akos712/projectY/ProjectY.png

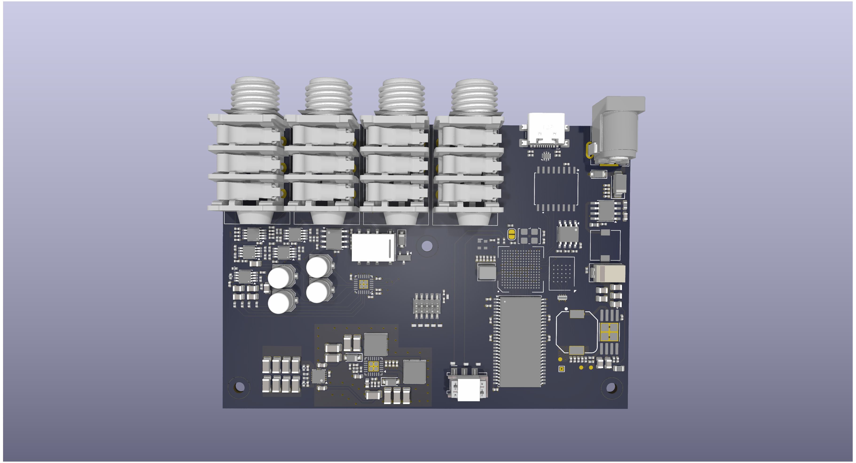
ProjectY.png
