akos712/projectY/ProjectY_3D_december.step

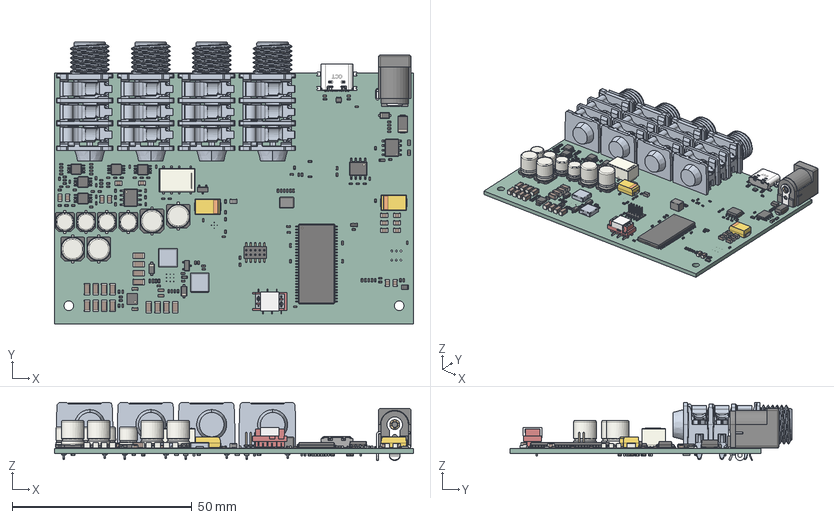
[picture p2: CAD file, 2025-12-16]
ProjectY_3D_december.step
100.0 x 78.6 x 16.2 mm
C_0402 x 100
Q_SOT-23
R_0402 x 58
C_Elec_6.3x7.7 x 4
ProjectY_3D_december 1.5.1 x 2
C_1206 x 16
C_Elec_5x5.8 x 4
SOT-666
C_0805 x 14
TI_SO-PowerPAD-8
R_0402_1005Metric x 4
J_Wurth_WR-MM_690367280676
R_0603 x 3
L_0805_2012Metric
Relay_DPDT_Omron_G6K-2F-Y
L_Wuerth_MAPI-4030
CP_EIA-7343-31_Kemet-D x 2
Texas_S-PVSON-N10
VSSOP-8_3x3mm_P0.65mm x 5
SOT-23
D_SOD-123FL
C_0603_1608Metric x 2
SOIC-8_3.9x4.9mm_P1.27mm x 2
R_0805
C_0603 x 3
PinHeader_2x05_P1.27mm_Vertical_SMD
D_SMA
D_SOD-123 x 2
R_0402x4
USB4110-GF-A_revB(1) MF
TSOP-II-54_22.2x10.16mm_P0.8mm
DFN1006-2L-RD x 6
R_0805_2012Metric x 4
ProjectY_PCB
