akos712/projectY/ProjectY_3D_latest.step

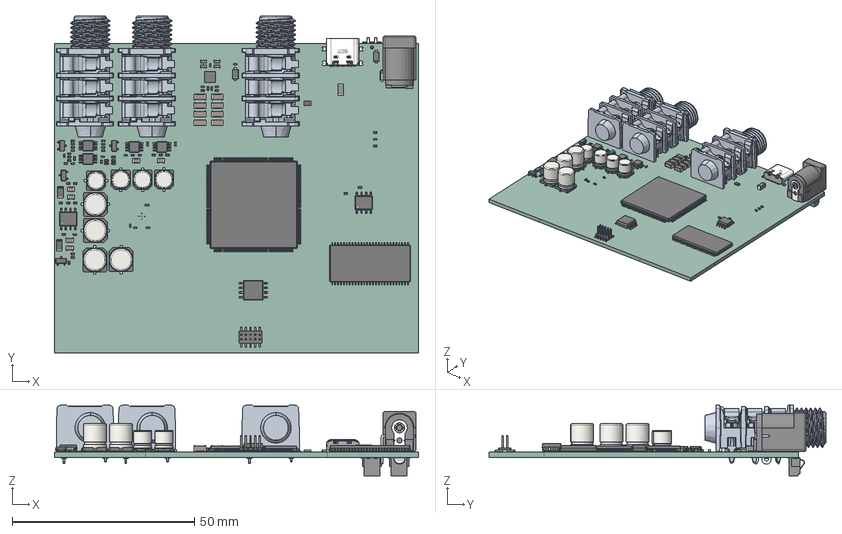
[picture p3: CAD file, 2025-10-03]
ProjectY_3D_latest.step
100.0 x 92.5 x 19.4 mm
C_Elec_6.3x7.7 x 4
C_0402 x 24
C_0603 x 4
C_Elec_5x5.8 x 4
C_1206 x 8
R_0402 x 27
SOT-23 x 4
R_0402_1005Metric x 6
R_1206 x 2
C_0805 x 6
L_1206_3216Metric
Texas_S-PVSON-N10
VSSOP-8_3x3mm_P0.65mm x 4
D_SOD-123FL x 2
SOIC-8_5.3x5.3mm_P1.27mm
SOIC-8_3.9x4.9mm_P1.27mm x 2
PinHeader_2x05_P1.27mm_Vertical_SMD
USB4110-GF-A_revB(1) MF
LQFP-176_24x24mm_P0.5mm
R_0805
TSOP-II-54_22.2x10.16mm_P0.8mm
00-9155-002-852-00X-STP-BM x 2
ProjectY_PCB
