akos712/projectY/ProjectY.step

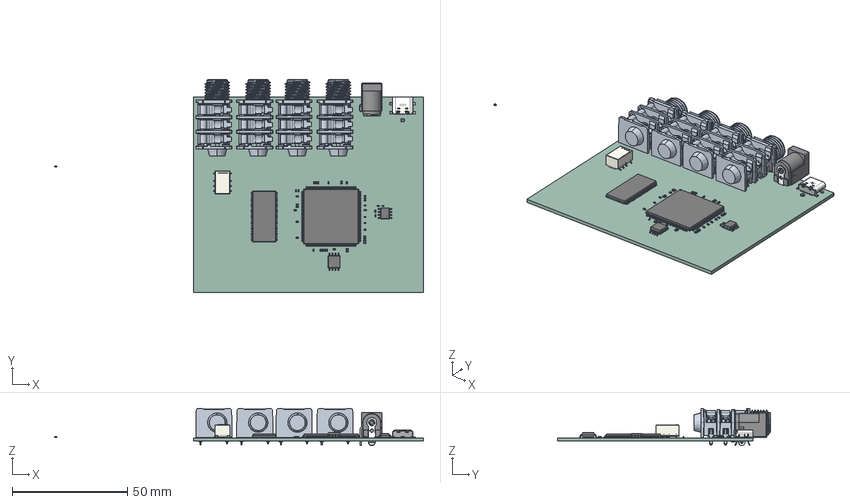
[picture p4: CAD file, 2025-08-23]
ProjectY.step
160.4 x 92.6 x 16.2 mm
SOT-666
C_0402 x 36
LQFP-176_24x24mm_P0.5mm
R_0402 x 4
Relay_DPDT_Omron_G6K-2F-Y
SOIC-8_5.3x5.3mm_P1.27mm
USB4110-GF-A_revB(1) MF
SOIC-8_3.9x4.9mm_P1.27mm
TSOP-II-54_22.2x10.16mm_P0.8mm
ProjectY_PCB
