akos712/projectY/simulations/3V3BuckInputFilter.asc

C1: cap; 27µ
C2: cap; 220n
C3: cap; 100µ
L1: ind; 22µ; Ipk=2 Rser=100m
R2: res; 1
R3: res; 1m
V1: voltage; ""; AC 1
Named nets: 0
@19V
.ac oct 100 20 1G
