akos712/projectY/ProjectY.kicad_pcb

## KiCad design ProjectY.kicad_pcb (2026-02-17)

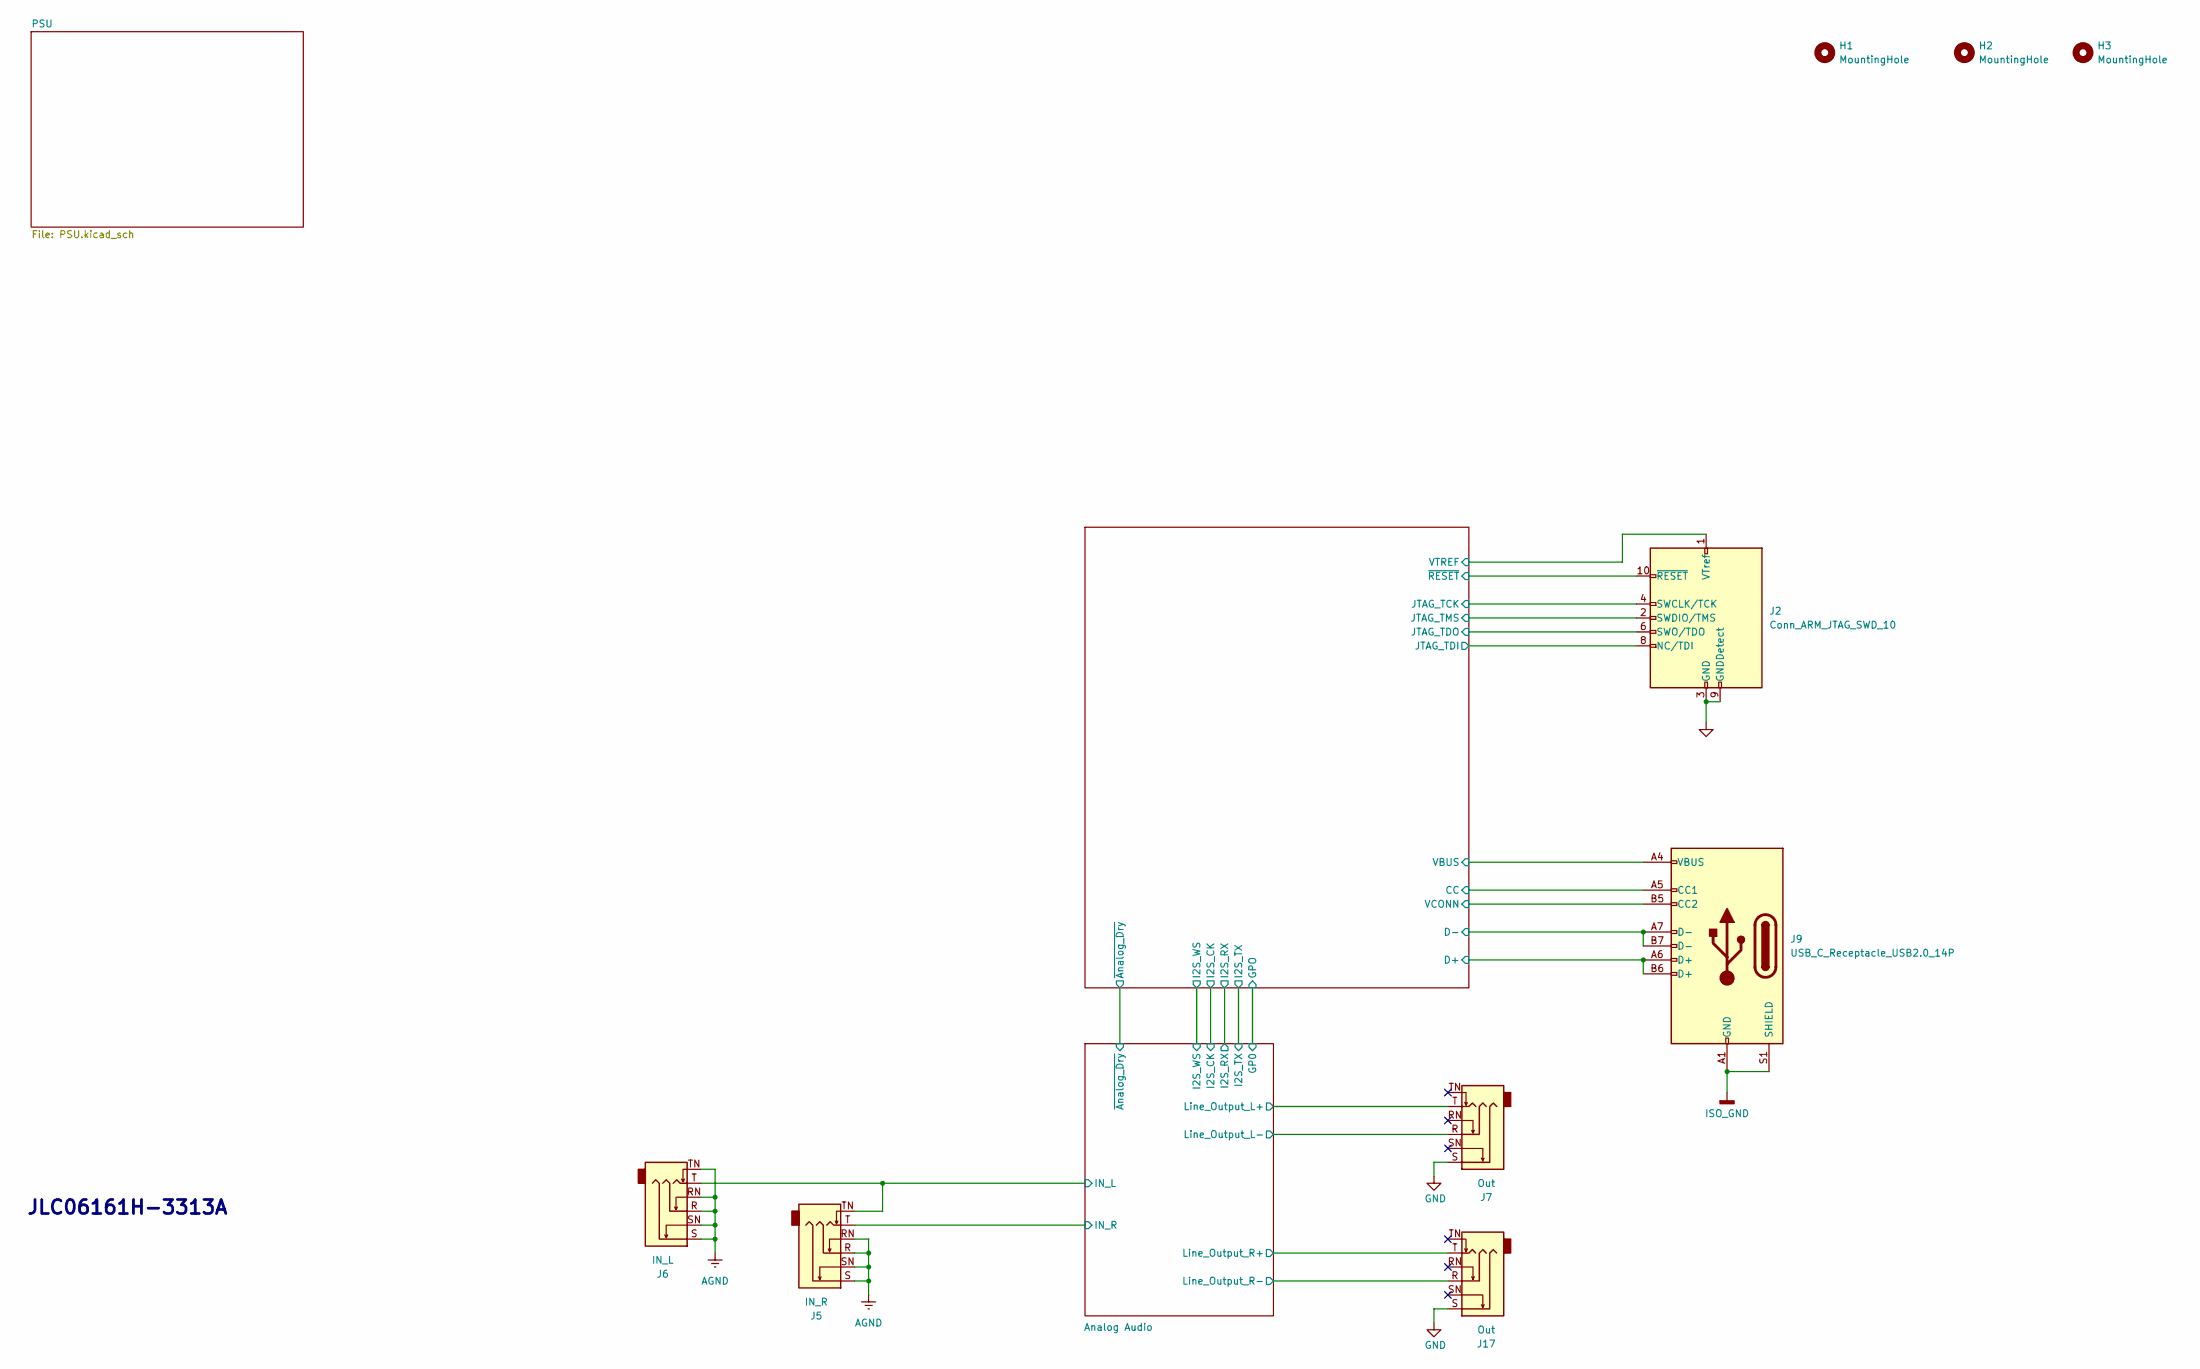
[picture p5: schematic ProjectY.kicad_sch, Project Y]

Parts:
H1, H2, H3: MountingHole; MountingHole_2.7mm_M2.5
J2: Conn_ARM_JTAG_SWD_10; PinHeader_2x05_P1.27mm_Vertical_SMD
J5: IN_R; Jack_6.35mm_Neutrik_NRJ6HF_Horizontal
J6: IN_L; Jack_6.35mm_Neutrik_NRJ6HF_Horizontal
J7, J17: Out; Jack_6.35mm_Neutrik_NRJ6HF_Horizontal
J9: USB_C_Receptacle_USB2.0_14P; USB_C_Receptacle_GCT_USB4110

Connections:
+3.3V: J2.1 (VTref); also elsewhere on the board
/Analog Audio/IN_L: J5.TN, J6.T; also elsewhere on the board
/Analog Audio/IN_R: J5.T; also elsewhere on the board
/Analog Audio/Line_Output_L+: J7.T; also elsewhere on the board
/Analog Audio/Line_Output_L-: J7.R; also elsewhere on the board
/Analog Audio/Line_Output_R+: J17.T; also elsewhere on the board
/Analog Audio/Line_Output_R-: J17.R; also elsewhere on the board
/DSP/CC: J9.A5 (CC1); also elsewhere on the board
/DSP/D+: J9.A6 (D+), J9.B6 (D+); also elsewhere on the board
/DSP/D-: J9.A7 (D-), J9.B7 (D-); also elsewhere on the board
/DSP/JTAG_TCK: J2.4 (SWCLK/TCK); also elsewhere on the board
/DSP/JTAG_TDI: J2.8 (NC/TDI); also elsewhere on the board
/DSP/JTAG_TDO: J2.6 (SWO/TDO); also elsewhere on the board
/DSP/JTAG_TMS: J2.2 (SWDIO/TMS); also elsewhere on the board
/DSP/VBUS: J9.A4 (VBUS), J9.A9 (VBUS), J9.B4 (VBUS), J9.B9 (VBUS); also elsewhere on the board
/DSP/VCONN: J9.B5 (CC2); also elsewhere on the board
/DSP/~RESET: J2.10 (~RESET); also elsewhere on the board
AGND: J5.R, J5.RN, J5.S, J5.SN, J6.R, J6.RN, J6.S, J6.SN, J6.TN; also elsewhere on the board
GND: J2.3 (GND), J2.5 (GND), J2.9 (GNDDetect), J7.S, J17.S; also elsewhere on the board
ISO_GND: J9.A1 (GND), J9.A12 (GND), J9.B1 (GND), J9.B12 (GND), J9.S1 (SHIELD); also elsewhere on the board

Notes on the sheet:
JLC06161H-3313A

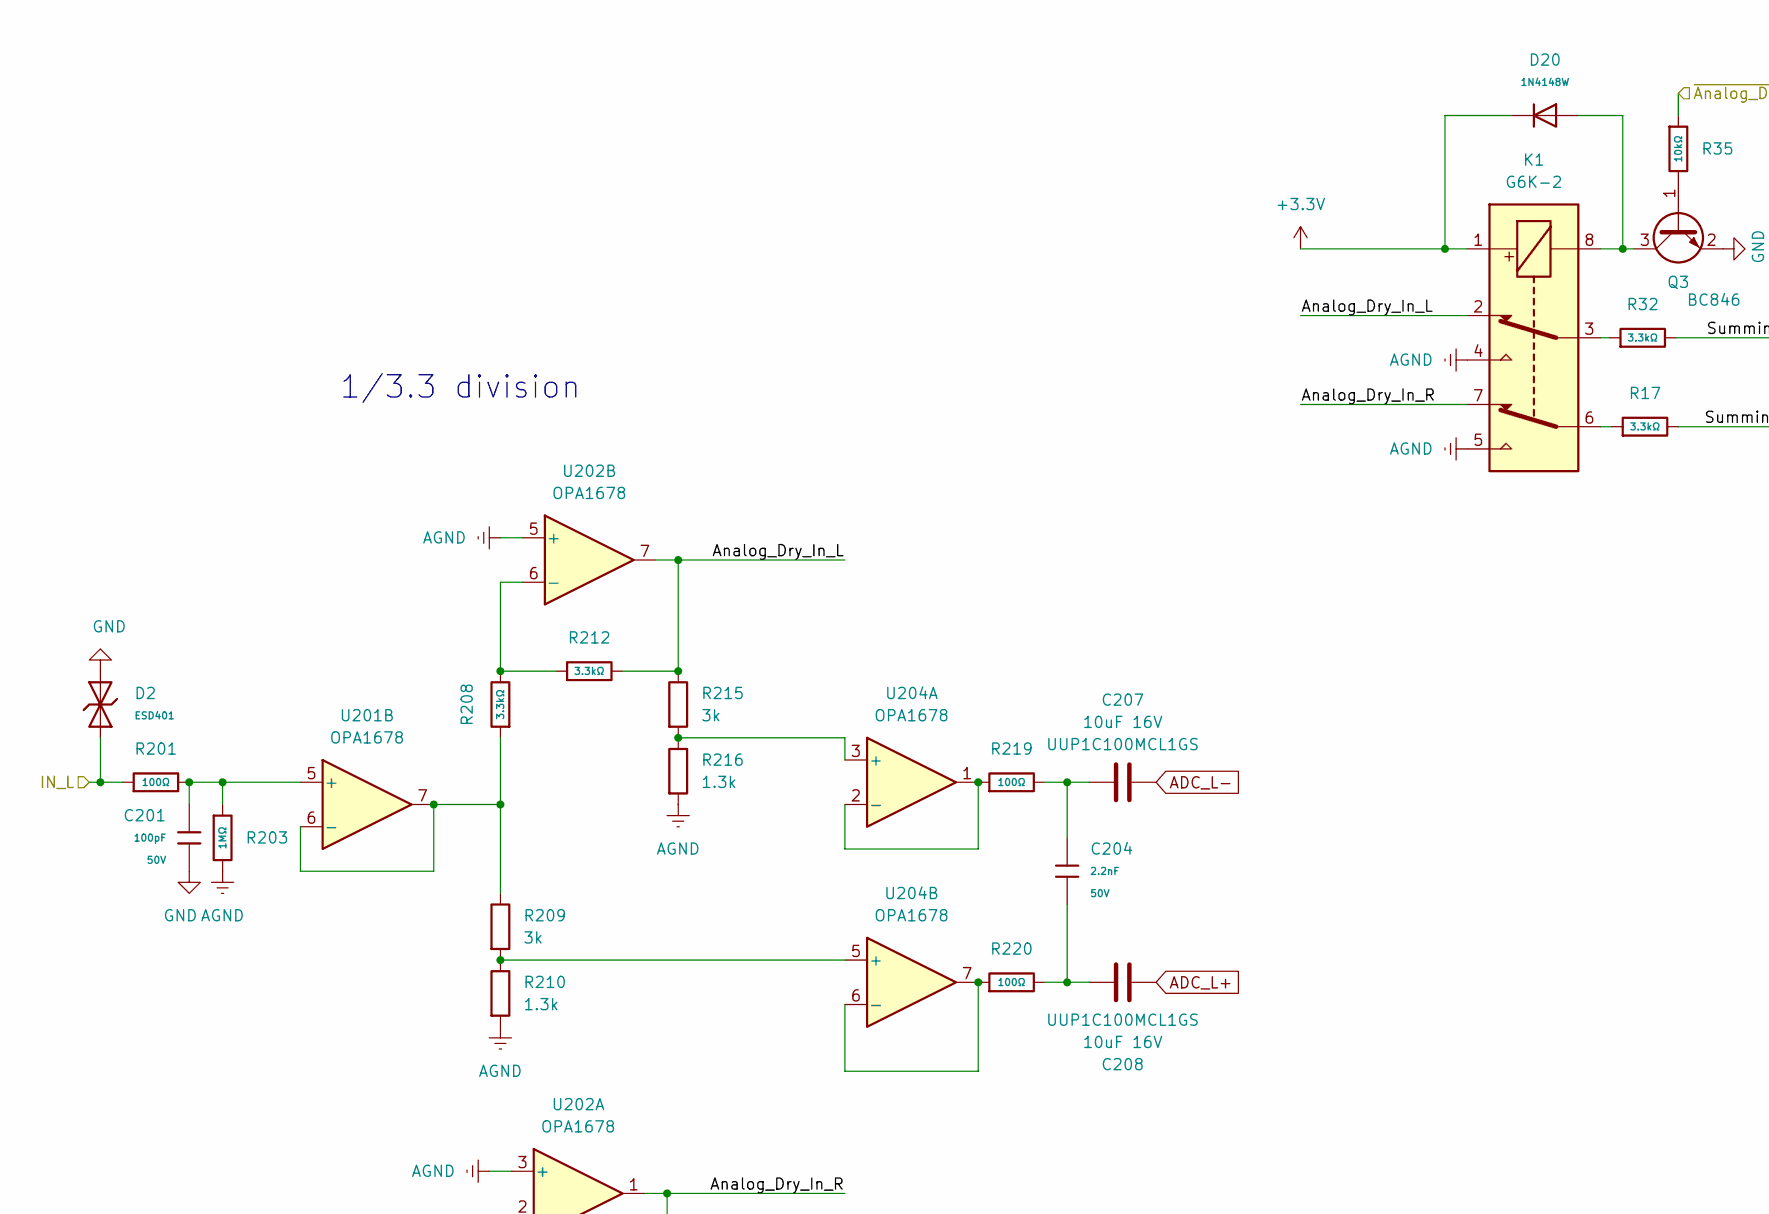
[picture p6: schematic audio.kicad_sch, Project Y, part in row 1, column 1]

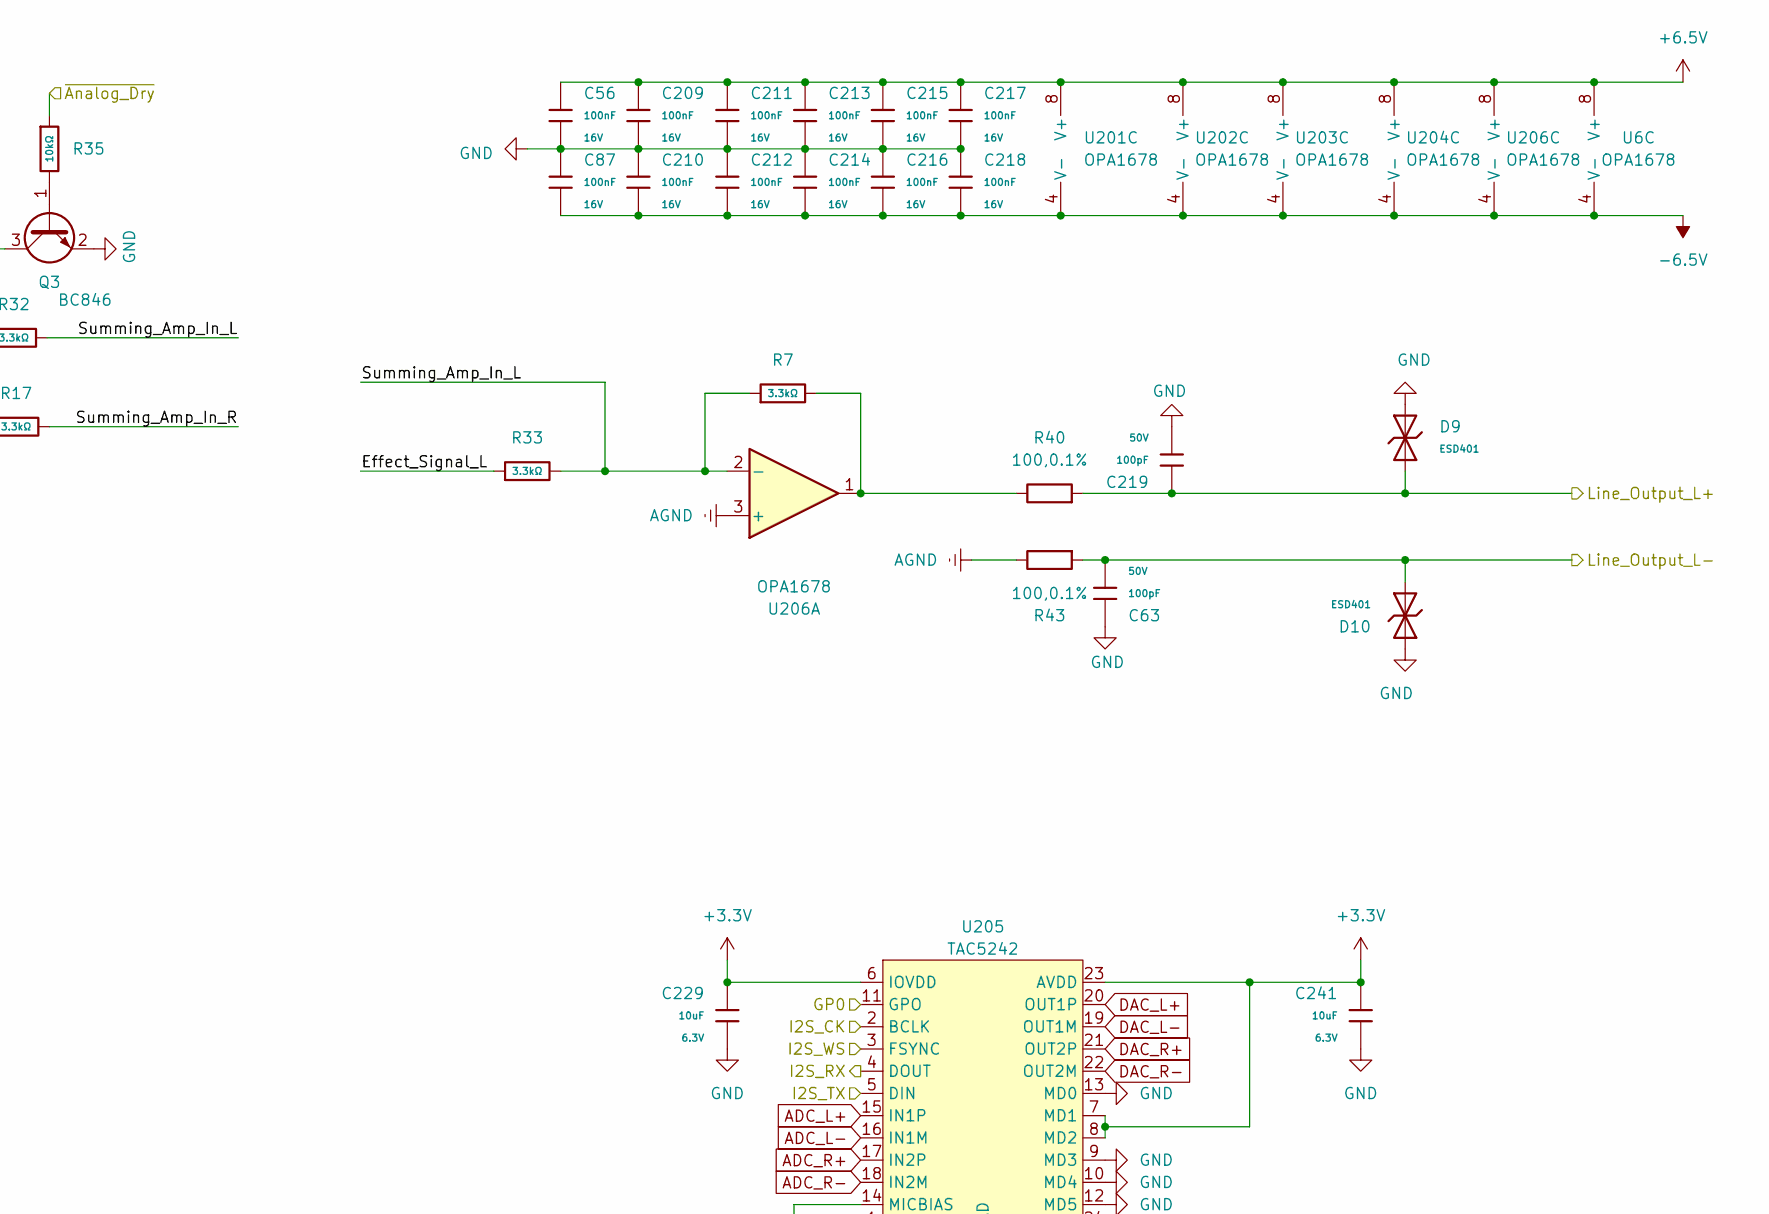
[picture p7: schematic audio.kicad_sch, Project Y, part in row 1, column 2]

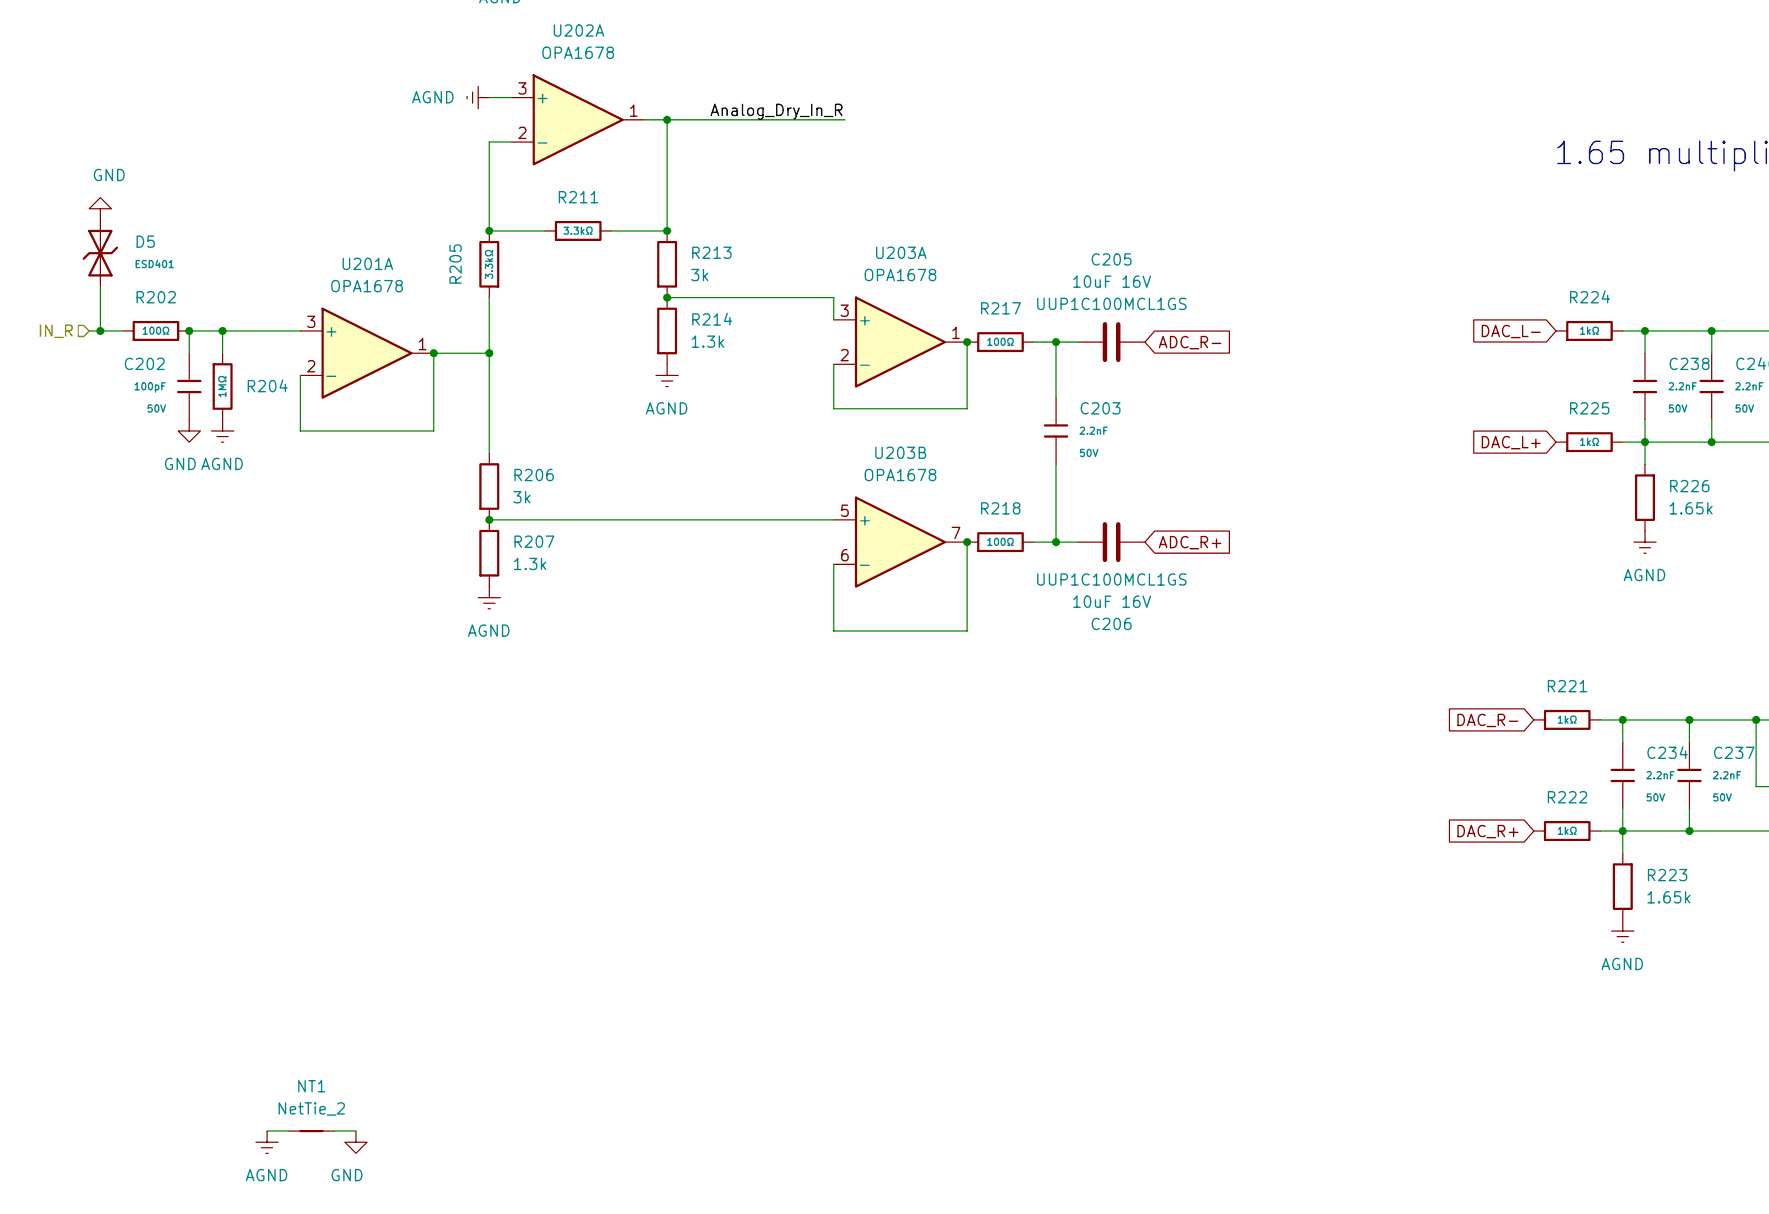
[picture p8: schematic audio.kicad_sch, Project Y, part in row 2, column 1]

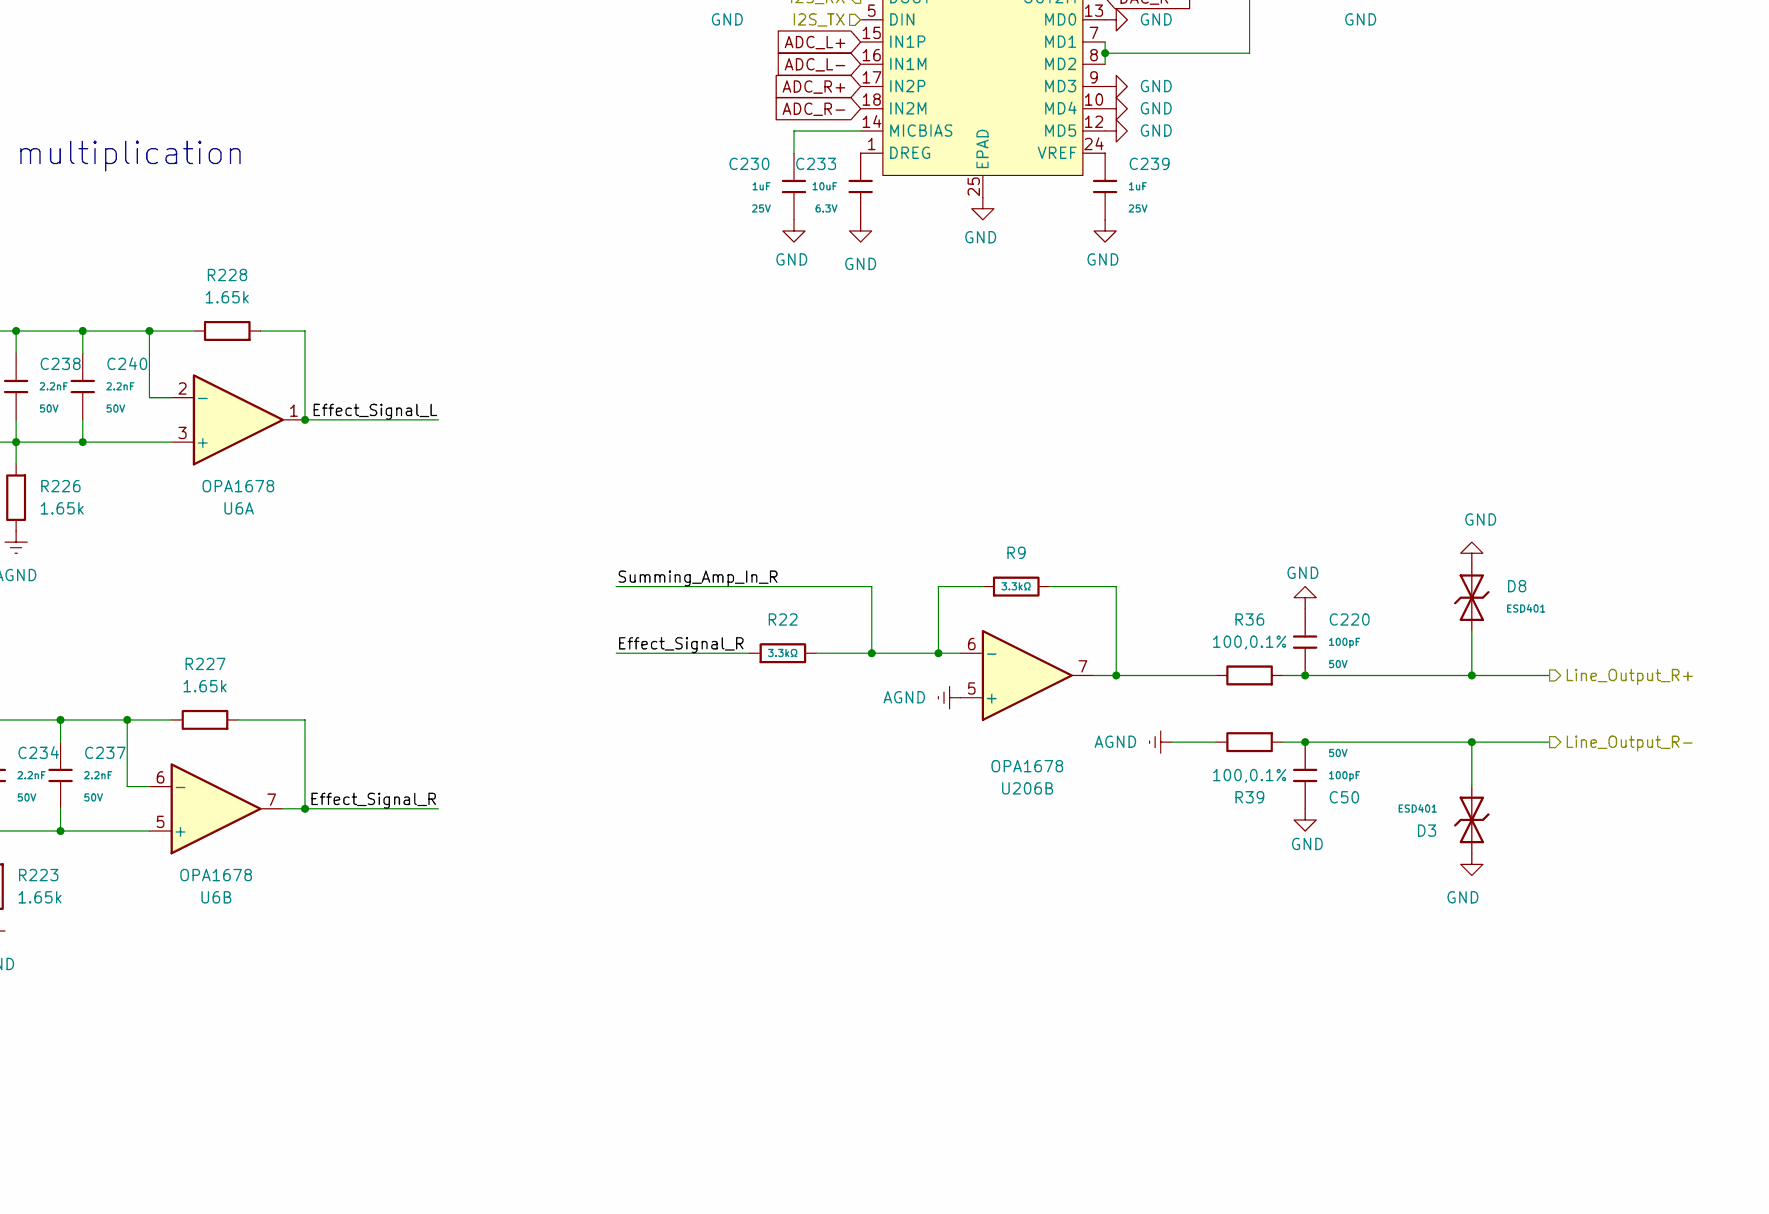
[picture p9: schematic audio.kicad_sch, Project Y, part in row 2, column 2]

Parts:
C50, C63, C201, C202, C219, C220: 100pF; C_0402; Voltage Rated 50V; Tolerance ±5%; Part 0402CG101J500NT; LCSC C1546
C56, C87, C209, C210, C211, C212, C213, C214, C215, C216, C217, C218: 100nF; C_0402; Voltage Rated 16V; Tolerance ±10%; Part CL05B104KO5NNNC; LCSC C1525
C203, C204, C234, C237, C238, C240: 2.2nF; C_0805; Voltage Rated 50V; Tolerance ±5%; Part CL21C222JBFNNNE; LCSC C28260
C205, C206, C207, C208: 10uF 16V; C_Elec_5x5.8; LCSC C1984751
C229, C233, C241: 10uF; C_0402; Voltage Rated 6.3V; Tolerance ±20%; Part CL05A106MQ5NUNC; LCSC C15525
C230, C239: 1uF; C_0402; Voltage Rated 25V; Tolerance ±10%; Part CL05A105KA5NQNC; LCSC C52923
D2, D3, D5, D8, D9, D10: ESD401; D_DFN1006-2L; Clamping Voltage@Ipp 10V; Breakdown Voltage (VBR) 5.6V; Part H5VL10B; LCSC C7420372
D20: 1N4148W; D_SOD-123; Forward Voltage (Vf@If) 1V@50mA; Reverse Voltage (Vr) 75V; Part 1N4148W; LCSC C81598
K1: G6K-2; Relay_DPDT_Omron_G6K-2F-Y
NT1: NetTie_2; NetTie-2_SMD_Pad0.5mm
Q3: BC846; SOT-23
R7, R9, R17, R22, R32, R33, R205, R208, R211, R212: 3.3kΩ; R_0402; Overload Voltage (Max) 50V; Tolerance ±1%; Part 0402WGF3301TCE; LCSC C25890
R35: 10kΩ; R_0402; Overload Voltage (Max) 50V; Tolerance ±1%; Part 0402WGF1002TCE; LCSC C25744
R36, R39, R40, R43: 100,0.1%; R_0805_2012Metric
R201, R202, R217, R218, R219, R220: 100Ω; R_0402; Overload Voltage (Max) 50V; Tolerance ±1%; Part 0402WGF1000TCE; LCSC C25076
R203, R204: 1MΩ; R_0402; Overload Voltage (Max) 50V; Tolerance ±1%; Part 0402WGF1004TCE; LCSC C26083
R206, R209, R213, R215: 3k; R_0402
R207, R210, R214, R216: 1.3k; R_0402
R221, R222, R224, R225: 1kΩ; R_0402; Overload Voltage (Max) 50V; Tolerance ±1%; Part 0402WGF1001TCE; LCSC C11702
R223, R227: 1.65k; R_0402_1005Metric
R226, R228: 1.65k; R_0402
U6, U201, U202, U203, U204: OPA1678; VSSOP-8_3x3mm_P0.65mm
U205: TAC5242
U206: OPA1678; SOIC-8_3.9x4.9mm_P1.27mm

Connections:
+3.3V: C229.1, C241.1, D20.1, K1.1, U205.6 (IOVDD), U205.7 (MD1), U205.8 (MD2), U205.23 (AVDD); also elsewhere on the board
+6.5V: C56.1, C209.1, C211.1, C213.1, C215.1, C217.1, U6.8 (V+), U201.8 (V+), U202.8 (V+), U203.8 (V+), U204.8 (V+), U206.8 (V+); also elsewhere on the board
-6.5V: C87.2, C210.2, C212.2, C214.2, C216.2, C218.2, U6.4 (V-), U201.4 (V-), U202.4 (V-), U203.4 (V-), U204.4 (V-), U206.4 (V-); also elsewhere on the board
/Analog Audio/Analog_Dry_In_L: K1.2, R212.2, R215.1, U202.7
/Analog Audio/Analog_Dry_In_R: K1.7, R211.2, R213.1, U202.1
/Analog Audio/Effect_Signal_L: R33.1, R228.2, U6.1
/Analog Audio/Effect_Signal_R: R22.1, R227.2, U6.7
/Analog Audio/GP0: U205.11 (GPO); also elsewhere on the board
/Analog Audio/I2S_CK: U205.2 (BCLK); also elsewhere on the board
/Analog Audio/I2S_RX: U205.4 (DOUT); also elsewhere on the board
/Analog Audio/I2S_TX: U205.5 (DIN); also elsewhere on the board
/Analog Audio/I2S_WS: U205.3 (FSYNC); also elsewhere on the board
/Analog Audio/IN_L: D2.1, R201.1; also elsewhere on the board
/Analog Audio/IN_R: D5.1, R202.1; also elsewhere on the board
/Analog Audio/Line_Output_L+: C219.1, D9.1, R40.2; also elsewhere on the board
/Analog Audio/Line_Output_L-: C63.2, D10.1, R43.2; also elsewhere on the board
/Analog Audio/Line_Output_R+: C220.2, D8.1, R36.2; also elsewhere on the board
/Analog Audio/Line_Output_R-: C50.2, D3.1, R39.2; also elsewhere on the board
/Analog Audio/Summing_Amp_In_L: R7.1, R32.2, R33.2, U206.2 (-)
/Analog Audio/Summing_Amp_In_R: R9.1, R17.2, R22.2, U206.6 (-)
/Analog Audio/~Analog_Dry: R35.1; also elsewhere on the board
ADC_L+: C208.1, U205.15 (IN1P)
ADC_L-: C207.1, U205.16 (IN1M)
ADC_R+: C206.1, U205.17 (IN2P)
ADC_R-: C205.1, U205.18 (IN2M)
AGND: K1.4, K1.5, NT1.1, R39.1, R43.1, R203.2, R204.2, R207.2, R210.2, R214.2, R216.2, R223.1, R226.1, U202.3 (+), U202.5 (+), U206.3 (+), U206.5 (+); also elsewhere on the board
DAC_L+: R225.1, U205.20 (OUT1P)
DAC_L-: R224.1, U205.19 (OUT1M)
DAC_R+: R222.1, U205.21 (OUT2P)
DAC_R-: R221.1, U205.22 (OUT2M)
GND: C50.1, C56.2, C63.1, C87.1, C201.2, C202.2, C209.2, C210.1, C211.2, C212.1, C213.2, C214.1, C215.2, C216.1, C217.2, C218.1, C219.2, C220.1, C229.2, C230.2, C233.2, C239.2, C241.2, D2.2, D3.2, D5.2, D8.2, D9.2, D10.2, NT1.2, Q3.2 (E), U205.9 (MD3), U205.10 (MD4), U205.12 (MD5), U205.13 (MD0), U205.25 (EPAD), U205.A1 (VSS), U205.A2 (VSS), U205.A3 (VSS), U205.A4 (VSS); also elsewhere on the board
unnamed: C203.1, C206.2, R218.2
unnamed: C203.2, C205.2, R217.2
unnamed: C204.1, C208.2, R220.2
unnamed: C204.2, C207.2, R219.2
unnamed: K1.3, R32.1
unnamed: K1.6, R17.1
unnamed: Q3.1 (B), R35.2
unnamed: D20.2, K1.8, Q3.3 (C)
unnamed: R9.2, R36.1, U206.7
unnamed: R7.2, R40.1, U206.1
unnamed: C238.1, C240.1, R225.2, R226.2, U6.3 (+)
unnamed: C238.2, C240.2, R224.2, R228.1, U6.2 (-)
unnamed: C234.1, C237.1, R222.2, R223.2, U6.5 (+)
unnamed: C234.2, C237.2, R221.2, R227.1, U6.6 (-)
unnamed: C202.1, R202.2, R204.1, U201.3 (+)
unnamed: R205.1, R206.1, U201.1, U201.2 (-)
unnamed: C201.1, R201.2, R203.1, U201.5 (+)
unnamed: R208.1, R209.1, U201.6 (-), U201.7
unnamed: R205.2, R211.1, U202.2 (-)
unnamed: R208.2, R212.1, U202.6 (-)
unnamed: R213.2, R214.1, U203.3 (+)
unnamed: R217.1, U203.1, U203.2 (-)
unnamed: R206.2, R207.1, U203.5 (+)
unnamed: R218.1, U203.6 (-), U203.7
unnamed: R215.2, R216.1, U204.3 (+)
unnamed: R219.1, U204.1, U204.2 (-)
unnamed: R209.2, R210.1, U204.5 (+)
unnamed: R220.1, U204.6 (-), U204.7
unnamed: C233.1, U205.1 (DREG)
unnamed: C230.1, U205.14 (MICBIAS)
unnamed: C239.1, U205.24 (VREF)

Notes on the sheet:
1.65 multiplication
1/3.3 division
