akos712/projectY/ProjectY.kicad_pcb

## KiCad design ProjectY.kicad_pcb (continued)

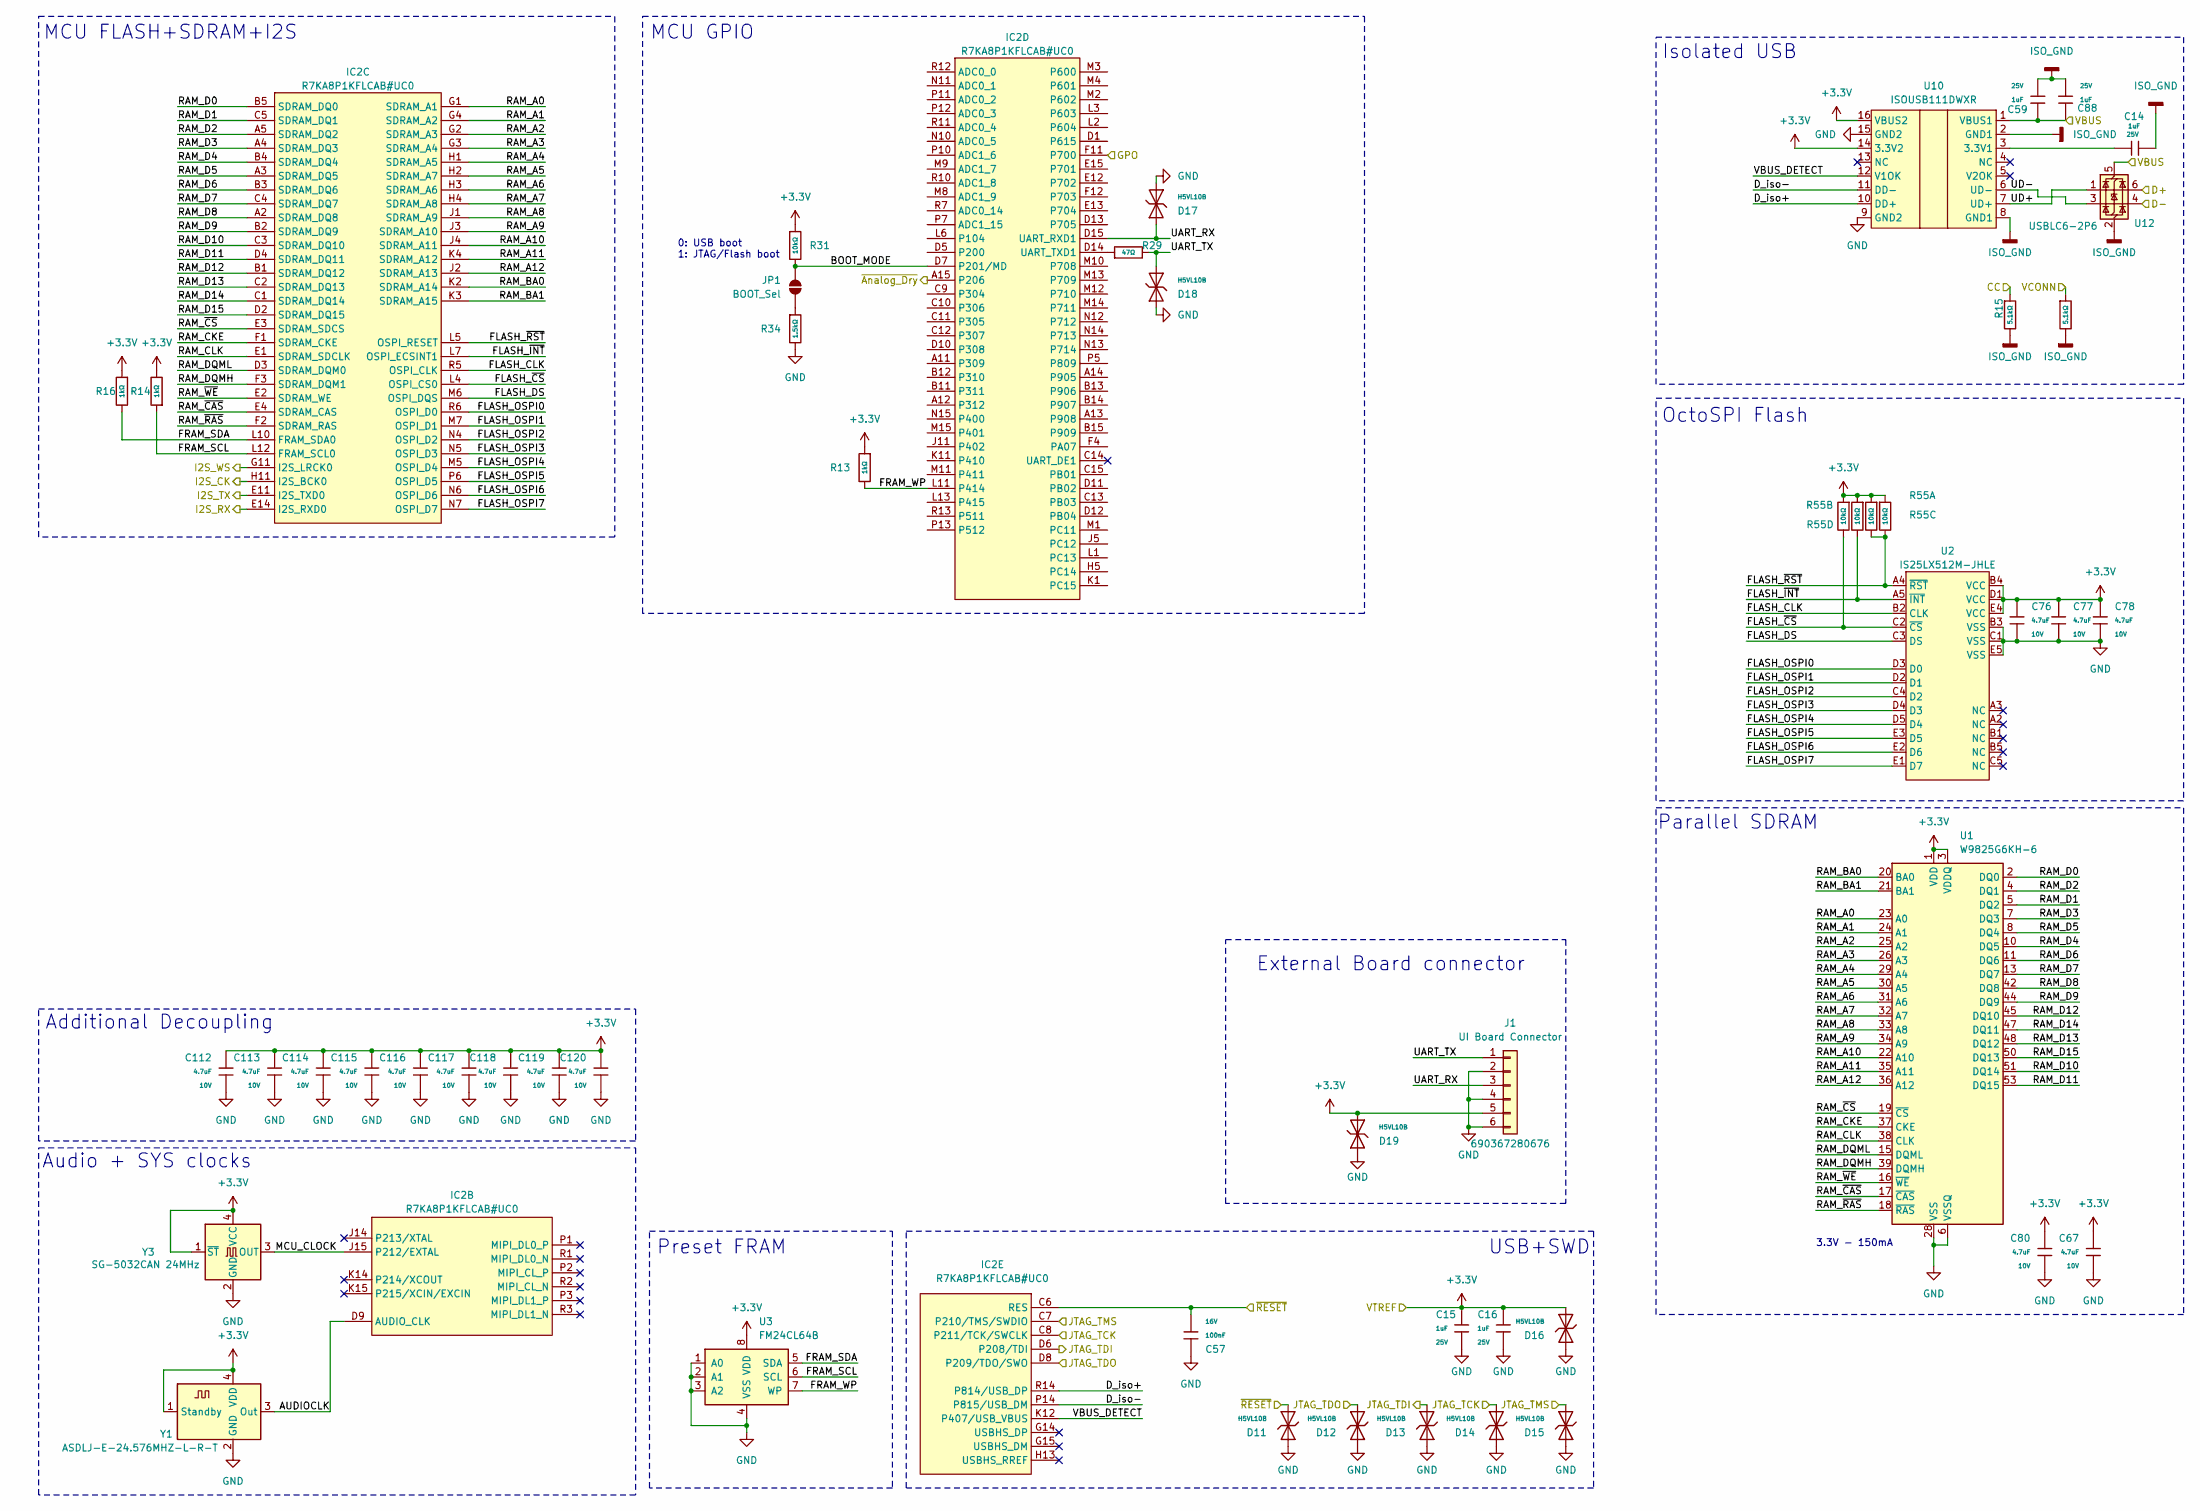
[picture p10: schematic MCU.kicad_sch, Project Y]

Parts:
C14, C15, C16, C59, C88: 1uF; C_0402; Voltage Rated 25V; Tolerance ±10%; Part CL05A105KA5NQNC; LCSC C52923
C57: 100nF; C_0402; Voltage Rated 16V; Tolerance ±10%; Part CL05B104KO5NNNC; LCSC C1525
C67, C76, C77, C78, C80, C112, C113, C114, C115, C116, C117, C118, C119, C120: 4.7uF; C_0402; Voltage Rated 10V; Tolerance ±20%; Part CL05A475MP5NRNC; LCSC C23733
D11, D12, D13, D14, D15, D16, D17, D18, D19: H5VL10B; D_DFN1006-2L; Clamping Voltage@Ipp 10V; Breakdown Voltage (VBR) 5.6V; Part H5VL10B; LCSC C7420372
IC2: R7KA8P1KFLCAB#UC0; BGA-225_15x15_11.0x11.0mm; Manufacturer_Part_Number R7KA8P1KFLCAB#UC0
J1: UI Board Connector; J_Wurth_WR-MM_690367280676
JP1: BOOT_Sel; SolderJumper-2_P1.3mm_Open_RoundedPad1.0x1.5mm
R1, R15: 5.1kΩ; R_0402; Overload Voltage (Max) 50V; Tolerance ±1%; Part 0402WGF5101TCE; LCSC C25905
R13, R14, R16: 1kΩ; R_0402; Overload Voltage (Max) 50V; Tolerance ±1%; Part 0402WGF1001TCE; LCSC C11702
R29: 47Ω; R_0402; Overload Voltage (Max) 50V; Tolerance ±1%; Part 0402WGF470JTCE; LCSC C25118
R31: 10kΩ; R_0402; Overload Voltage (Max) 50V; Tolerance ±1%; Part 0402WGF1002TCE; LCSC C25744
R34: 1.5kΩ; R_0402; Overload Voltage (Max) 50V; Tolerance ±1%; Part 0402WGF1501TCE; LCSC C25867
R55: 10kΩ; R_0402x4; Tolerance ±5%; Part 4D02WGJ0103TCE; LCSC C25725
U1: W9825G6KH-6; TSOP-II-54_22.2x10.16mm_P0.8mm; LCSC C97572
U2: IS25LX512M-JHLE; BGA-24_6x8mm_Layout5x5_P1.0mm
U3: FM24CL64B; SOIC-8_3.9x4.9mm_P1.27mm; LCSC C9829
U10: ISOUSB111DWXR; SOIC16_DW_TEX-L
U12: USBLC6-2P6; SOT-666
Y1: ASDLJ-E-24.576MHZ-L-R-T; Oscillator_SMD_Abracon_ASDMB-4Pin_2.5x2.0mm
Y3: SG-5032CAN 24MHz; Oscillator_SMD_SeikoEpson_SG8002LB-4Pin_5.0x3.2mm

Connections:
+3.3V: C15.2, C16.2, C67.1, C76.1, C77.1, C78.1, C80.1, C112.1, C113.1, C114.1, C115.1, C116.1, C117.1, C118.1, C119.1, C120.1, D16.1, D19.1, J1.5, R13.1, R14.2, R16.1, R31.1, R55.1, R55.2, R55.3, R55.4, U1.1 (VDD), U1.3 (VDDQ), U1.9 (VDDQ), U1.14 (VDD), U1.27 (VDD), U1.43 (VDDQ), U1.49 (VDDQ), U2.B4 (VCC), U2.D1 (VCC), U2.E4 (VCC), U3.8 (VDD), U10.14 (3.3V2), U10.16 (VBUS2), Y1.1 (Standby), Y1.4 (VDD), Y3.1 (~ST), Y3.4 (VCC); also elsewhere on the board
/Analog Audio/GP0: IC2.F11 (P700); also elsewhere on the board
/Analog Audio/I2S_CK: IC2.H11 (I2S_BCK0); also elsewhere on the board
/Analog Audio/I2S_RX: IC2.E14 (I2S_RXD0); also elsewhere on the board
/Analog Audio/I2S_TX: IC2.E11 (I2S_TXD0); also elsewhere on the board
/Analog Audio/I2S_WS: IC2.G11 (I2S_LRCK0); also elsewhere on the board
/Analog Audio/~Analog_Dry: IC2.A15 (P206); also elsewhere on the board
/DSP/AUDIOCLK: IC2.D9 (AUDIO_CLK), Y1.3 (Out)
/DSP/BOOT_MODE: IC2.D7 (P201/MD), JP1.2 (B), R31.2
/DSP/CC: R15.1; also elsewhere on the board
/DSP/D+: U12.6 (I/O1); also elsewhere on the board
/DSP/D-: U12.4 (I/O2); also elsewhere on the board
/DSP/D_iso+: IC2.R14 (P814/USB_DP), U10.10 (DD+)
/DSP/D_iso-: IC2.P14 (P815/USB_DM), U10.11 (DD-)
/DSP/FLASH_CLK: IC2.R5 (OSPI_CLK), U2.B2 (CLK)
/DSP/FLASH_DS: IC2.M6 (OSPI_DQS), U2.C3 (DS)
/DSP/FLASH_OSPI0: IC2.R6 (OSPI_D0), U2.D3 (D0)
/DSP/FLASH_OSPI1: IC2.M7 (OSPI_D1), U2.D2 (D1)
/DSP/FLASH_OSPI2: IC2.N4 (OSPI_D2), U2.C4 (D2)
/DSP/FLASH_OSPI3: IC2.N5 (OSPI_D3), U2.D4 (D3)
/DSP/FLASH_OSPI4: IC2.M5 (OSPI_D4), U2.D5 (D4)
/DSP/FLASH_OSPI5: IC2.P6 (OSPI_D5), U2.E3 (D5)
/DSP/FLASH_OSPI6: IC2.N6 (OSPI_D6), U2.E2 (D6)
/DSP/FLASH_OSPI7: IC2.N7 (OSPI_D7), U2.E1 (D7)
/DSP/FLASH_~CS: IC2.L4 (OSPI_CS0), R55.5, U2.C2 (~CS)
/DSP/FLASH_~INT: IC2.L7 (OSPI_ECSINT1), R55.8, U2.A5 (~INT)
/DSP/FLASH_~RST: IC2.L5 (OSPI_RESET), R55.6, R55.7, U2.A4 (~RST)
/DSP/FRAM_SCL: IC2.L12 (FRAM_SCL0), R14.1, U3.6 (SCL)
/DSP/FRAM_SDA: IC2.L10 (FRAM_SDA0), R16.2, U3.5 (SDA)
/DSP/FRAM_WP: IC2.L11 (P414), R13.2, U3.7 (WP)
/DSP/JTAG_TCK: D14.1, IC2.C8 (P211/TCK/SWCLK); also elsewhere on the board
/DSP/JTAG_TDI: D13.1, IC2.D6 (P208/TDI); also elsewhere on the board
/DSP/JTAG_TDO: D12.1, IC2.D8 (P209/TDO/SWO); also elsewhere on the board
/DSP/JTAG_TMS: D15.1, IC2.C7 (P210/TMS/SWDIO); also elsewhere on the board
/DSP/MCU_CLOCK: IC2.J15 (P212/EXTAL), Y3.3 (OUT)
/DSP/RAM_A0: IC2.G1 (SDRAM_A1), U1.23 (A0)
/DSP/RAM_A1: IC2.G4 (SDRAM_A2), U1.24 (A1)
/DSP/RAM_A2: IC2.G2 (SDRAM_A3), U1.25 (A2)
/DSP/RAM_A3: IC2.G3 (SDRAM_A4), U1.26 (A3)
/DSP/RAM_A4: IC2.H1 (SDRAM_A5), U1.29 (A4)
/DSP/RAM_A5: IC2.H2 (SDRAM_A7), U1.30 (A5)
/DSP/RAM_A6: IC2.H3 (SDRAM_A6), U1.31 (A6)
/DSP/RAM_A7: IC2.H4 (SDRAM_A8), U1.32 (A7)
/DSP/RAM_A8: IC2.J1 (SDRAM_A9), U1.33 (A8)
/DSP/RAM_A9: IC2.J3 (SDRAM_A10), U1.34 (A9)
/DSP/RAM_A10: IC2.J4 (SDRAM_A11), U1.22 (A10)
/DSP/RAM_A11: IC2.K4 (SDRAM_A12), U1.35 (A11)
/DSP/RAM_A12: IC2.J2 (SDRAM_A13), U1.36 (A12)
/DSP/RAM_BA0: IC2.K2 (SDRAM_A14), U1.20 (BA0)
/DSP/RAM_BA1: IC2.K3 (SDRAM_A15), U1.21 (BA1)
/DSP/RAM_CKE: IC2.F1 (SDRAM_CKE), U1.37 (CKE)
/DSP/RAM_CLK: IC2.E1 (SDRAM_SDCLK), U1.38 (CLK)
/DSP/RAM_D0: IC2.B5 (SDRAM_DQ0), U1.2 (DQ0)
/DSP/RAM_D1: IC2.C5 (SDRAM_DQ1), U1.5 (DQ2)
/DSP/RAM_D2: IC2.A5 (SDRAM_DQ2), U1.4 (DQ1)
/DSP/RAM_D3: IC2.A4 (SDRAM_DQ3), U1.7 (DQ3)
/DSP/RAM_D4: IC2.B4 (SDRAM_DQ4), U1.10 (DQ5)
/DSP/RAM_D5: IC2.A3 (SDRAM_DQ5), U1.8 (DQ4)
/DSP/RAM_D6: IC2.B3 (SDRAM_DQ6), U1.11 (DQ6)
/DSP/RAM_D7: IC2.C4 (SDRAM_DQ7), U1.13 (DQ7)
/DSP/RAM_D8: IC2.A2 (SDRAM_DQ8), U1.42 (DQ8)
/DSP/RAM_D9: IC2.B2 (SDRAM_DQ9), U1.44 (DQ9)
/DSP/RAM_D10: IC2.C3 (SDRAM_DQ10), U1.51 (DQ14)
/DSP/RAM_D11: IC2.D4 (SDRAM_DQ11), U1.53 (DQ15)
/DSP/RAM_D12: IC2.B1 (SDRAM_DQ12), U1.45 (DQ10)
/DSP/RAM_D13: IC2.C2 (SDRAM_DQ13), U1.48 (DQ12)
/DSP/RAM_D14: IC2.C1 (SDRAM_DQ14), U1.47 (DQ11)
/DSP/RAM_D15: IC2.D2 (SDRAM_DQ15), U1.50 (DQ13)
/DSP/RAM_DQMH: IC2.F3 (SDRAM_DQM1), U1.39 (DQMH)
/DSP/RAM_DQML: IC2.D3 (SDRAM_DQM0), U1.15 (DQML)
/DSP/RAM_~CAS: IC2.E4 (SDRAM_CAS), U1.17 (~CAS)
/DSP/RAM_~CS: IC2.E3 (SDRAM_SDCS), U1.19 (~CS)
/DSP/RAM_~RAS: IC2.F2 (SDRAM_RAS), U1.18 (~RAS)
/DSP/RAM_~WE: IC2.E2 (SDRAM_WE), U1.16 (~WE)
/DSP/UART_RX: D17.2, IC2.D15 (UART_RXD1), J1.3
/DSP/UART_TX: D18.1, J1.1, R29.2
/DSP/UD+: U10.7 (UD+), U12.1 (I/O1)
/DSP/UD-: U10.6 (UD-), U12.3 (I/O2)
/DSP/VBUS: C59.1, C88.1, U10.1 (VBUS1), U12.5 (VBUS); also elsewhere on the board
/DSP/VBUS_DETECT: IC2.K12 (P407/USB_VBUS), U10.12 (V1OK)
/DSP/VCONN: R1.1; also elsewhere on the board
/DSP/~RESET: C57.2, D11.1, IC2.C6 (RES); also elsewhere on the board
GND: C15.1, C16.1, C57.1, C67.2, C76.2, C77.2, C78.2, C80.2, C112.2, C113.2, C114.2, C115.2, C116.2, C117.2, C118.2, C119.2, C120.2, D11.2, D12.2, D13.2, D14.2, D15.2, D16.2, D17.1, D18.2, D19.2, J1.2, J1.4, J1.6, R34.2, U1.6 (VSSQ), U1.12 (VSSQ), U1.28 (VSS), U1.41 (VSS), U1.46 (VSSQ), U1.52 (VSSQ), U1.54 (VSS), U2.B3 (VSS), U2.C1 (VSS), U2.E5 (VSS), U3.1 (A0), U3.2 (A1), U3.3 (A2), U3.4 (VSS), U10.9 (GND2), U10.15 (GND2), Y1.2 (GND), Y3.2 (GND); also elsewhere on the board
ISO_GND: C14.2, C59.2, C88.2, R1.2, R15.2, U10.2 (GND1), U10.8 (GND1), U12.2 (GND); also elsewhere on the board
unnamed: IC2.D14 (UART_TXD1), R29.1
unnamed: JP1.1 (A), R34.1
unnamed: C14.1, U10.3 (3.3V1)

Notes on the sheet:
OctoSPI Flash
Isolated USB
MCU GPIO
Parallel SDRAM
MCU FLASH+SDRAM+I2S
3.3V - 150mA
0: USB boot 1: JTAG/Flash boot
External Board connector
Audio + SYS clocks
USB+SWD
Preset FRAM
Additional Decoupling

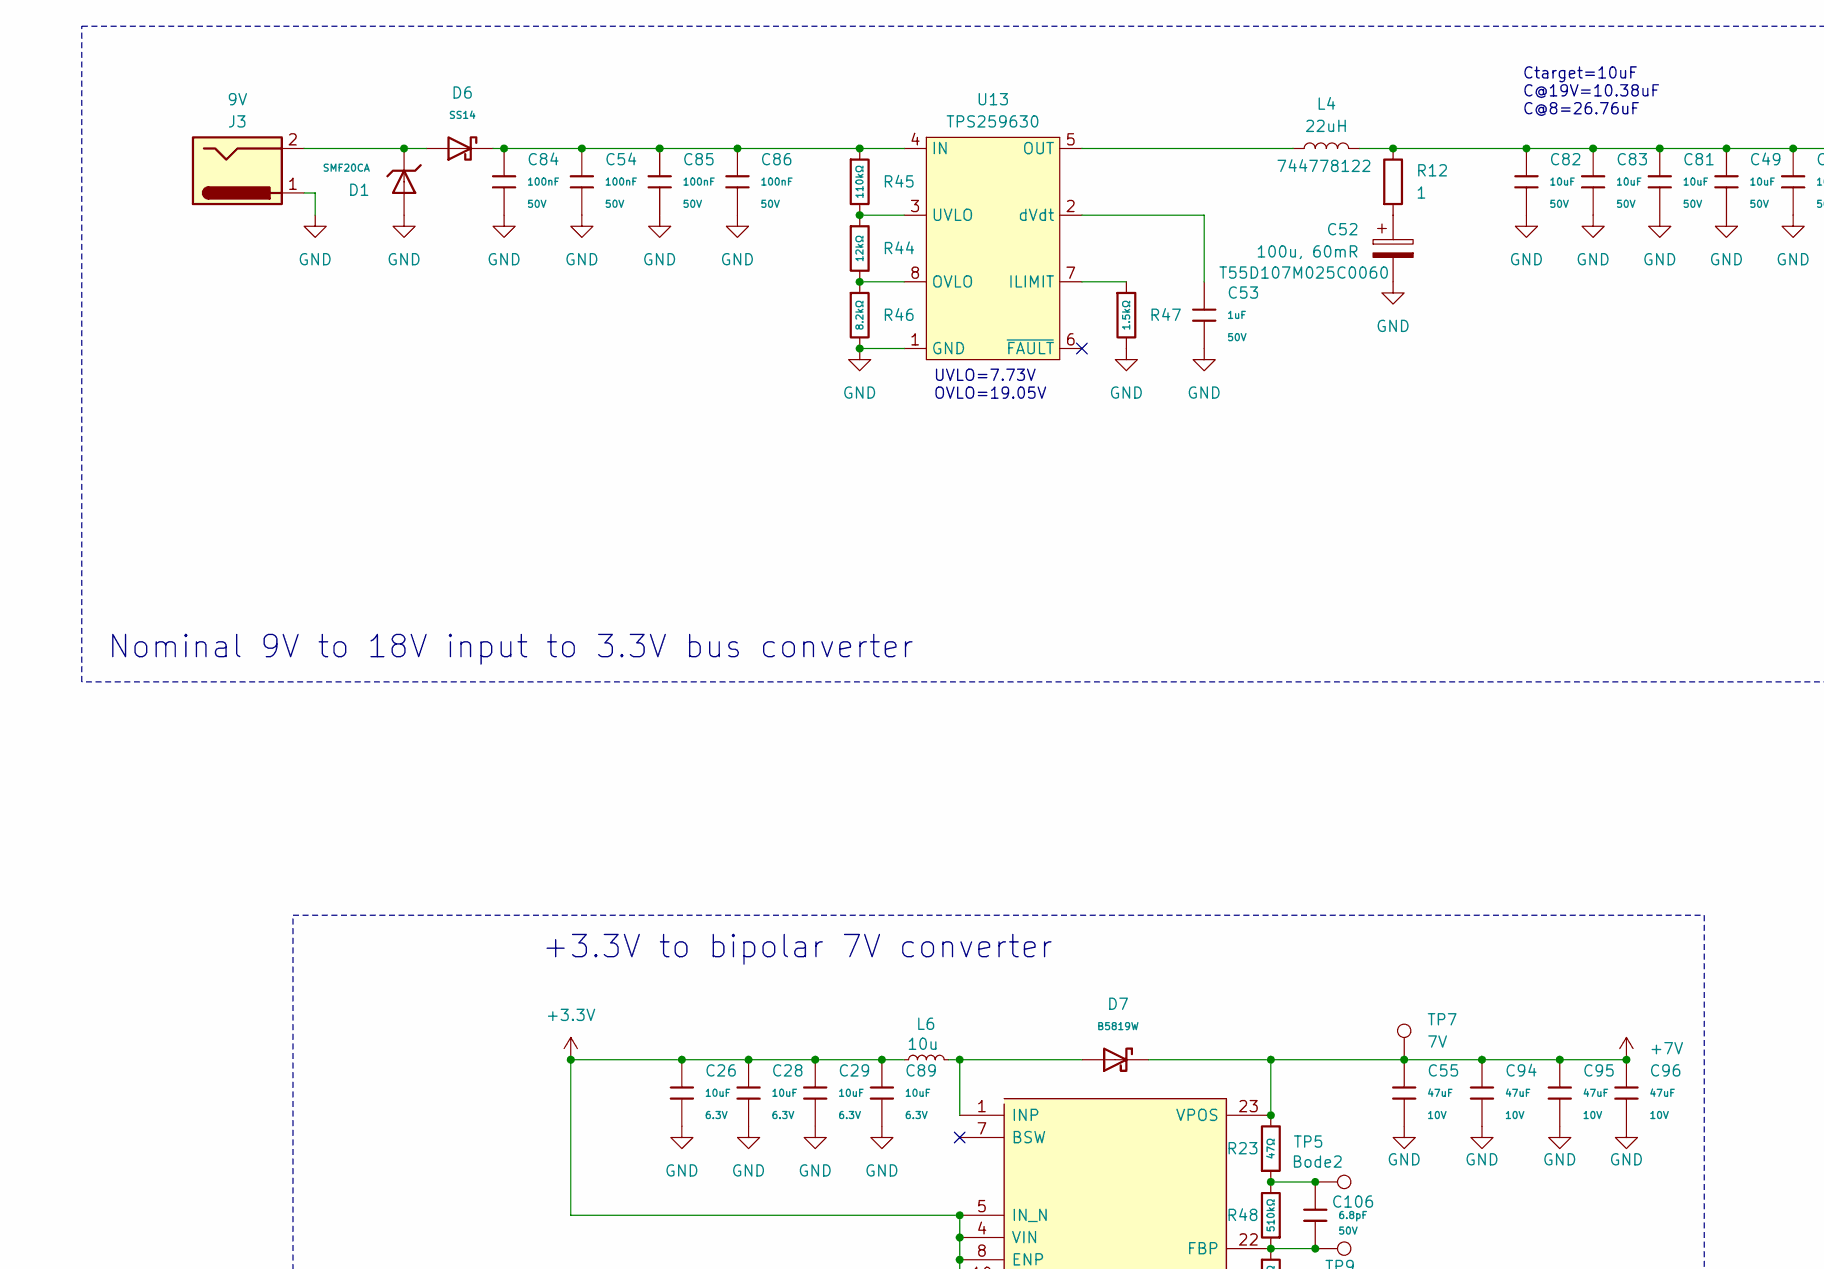
[picture p11: schematic PSU.kicad_sch, Project Y, part in row 1, column 1]

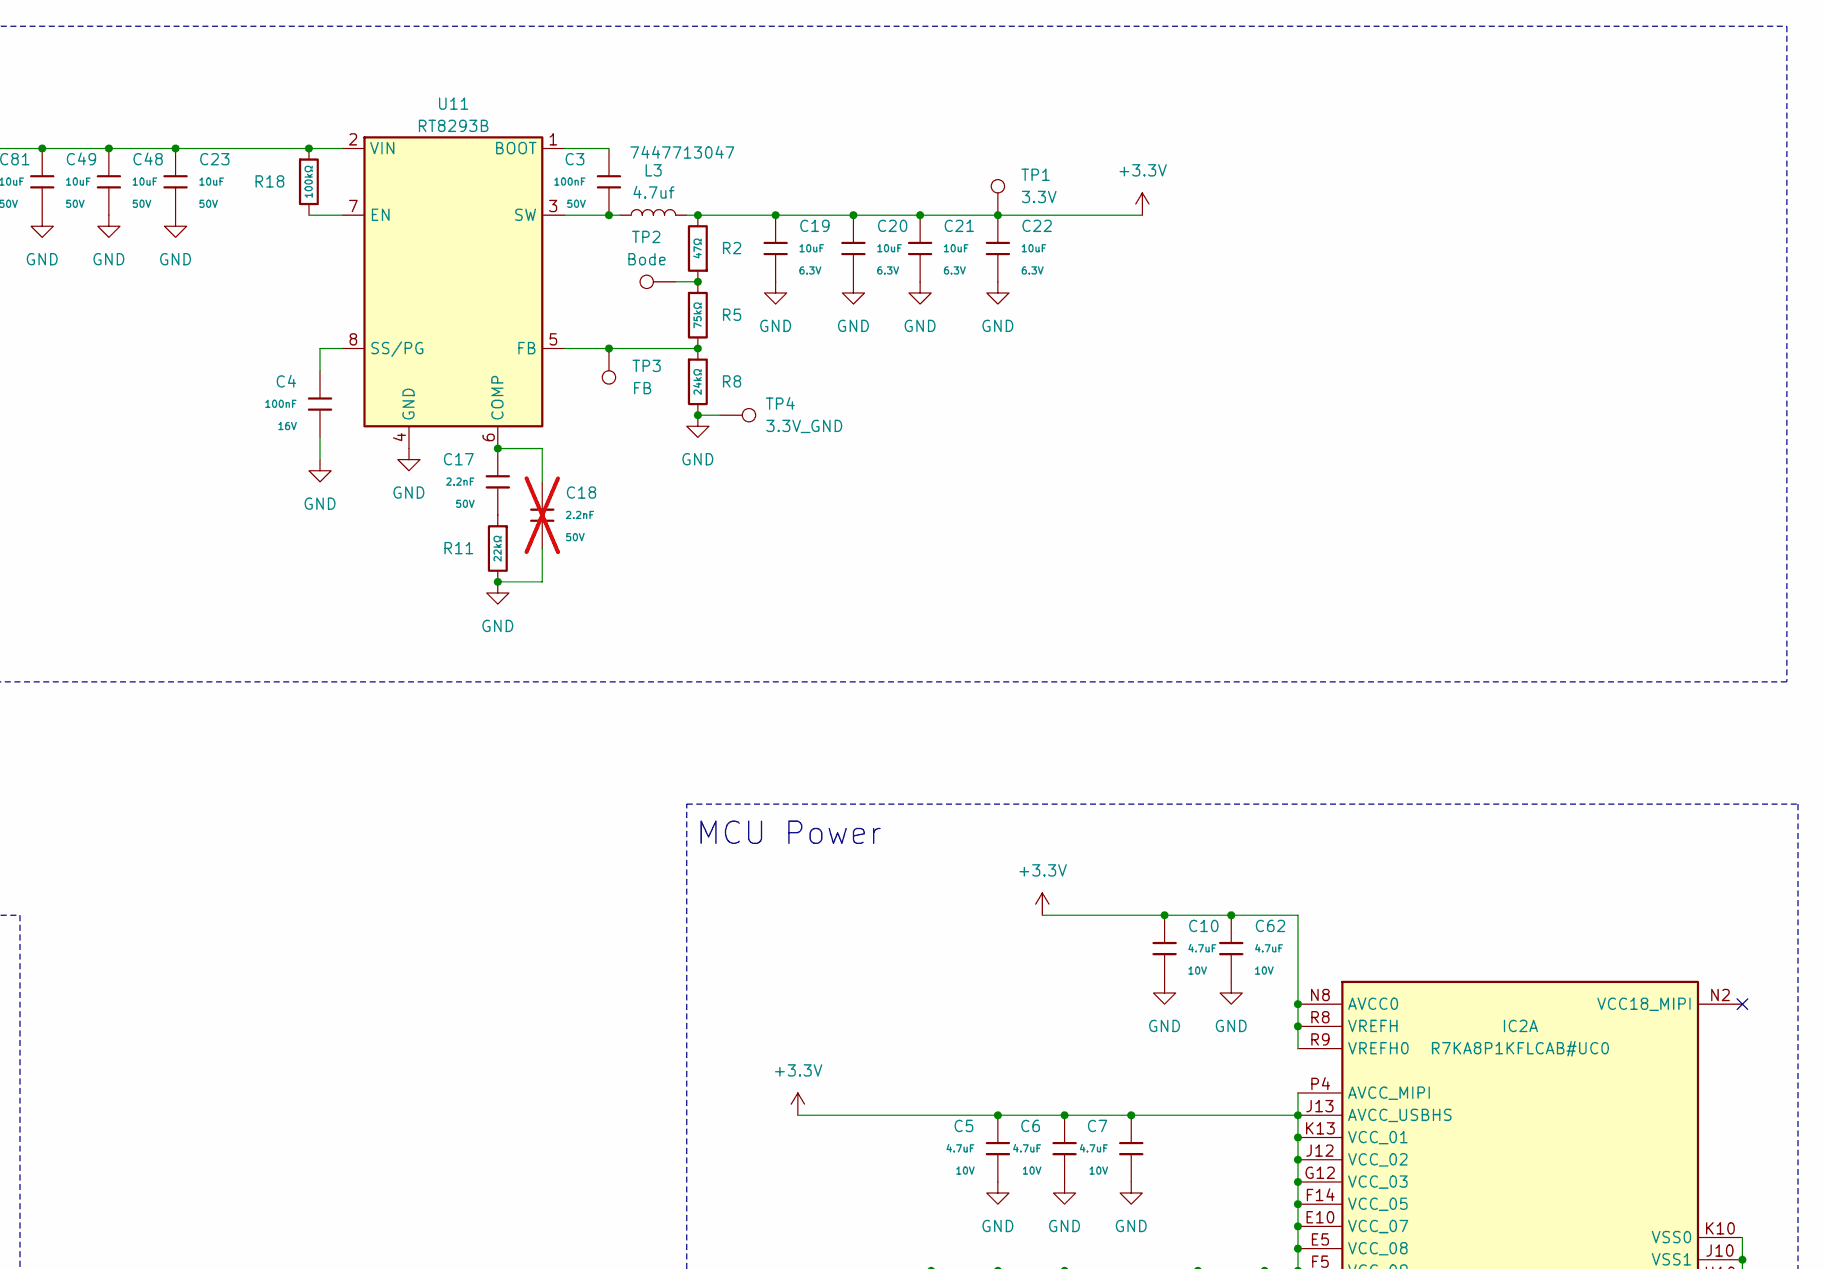
[picture p12: schematic PSU.kicad_sch, Project Y, part in row 1, column 2]

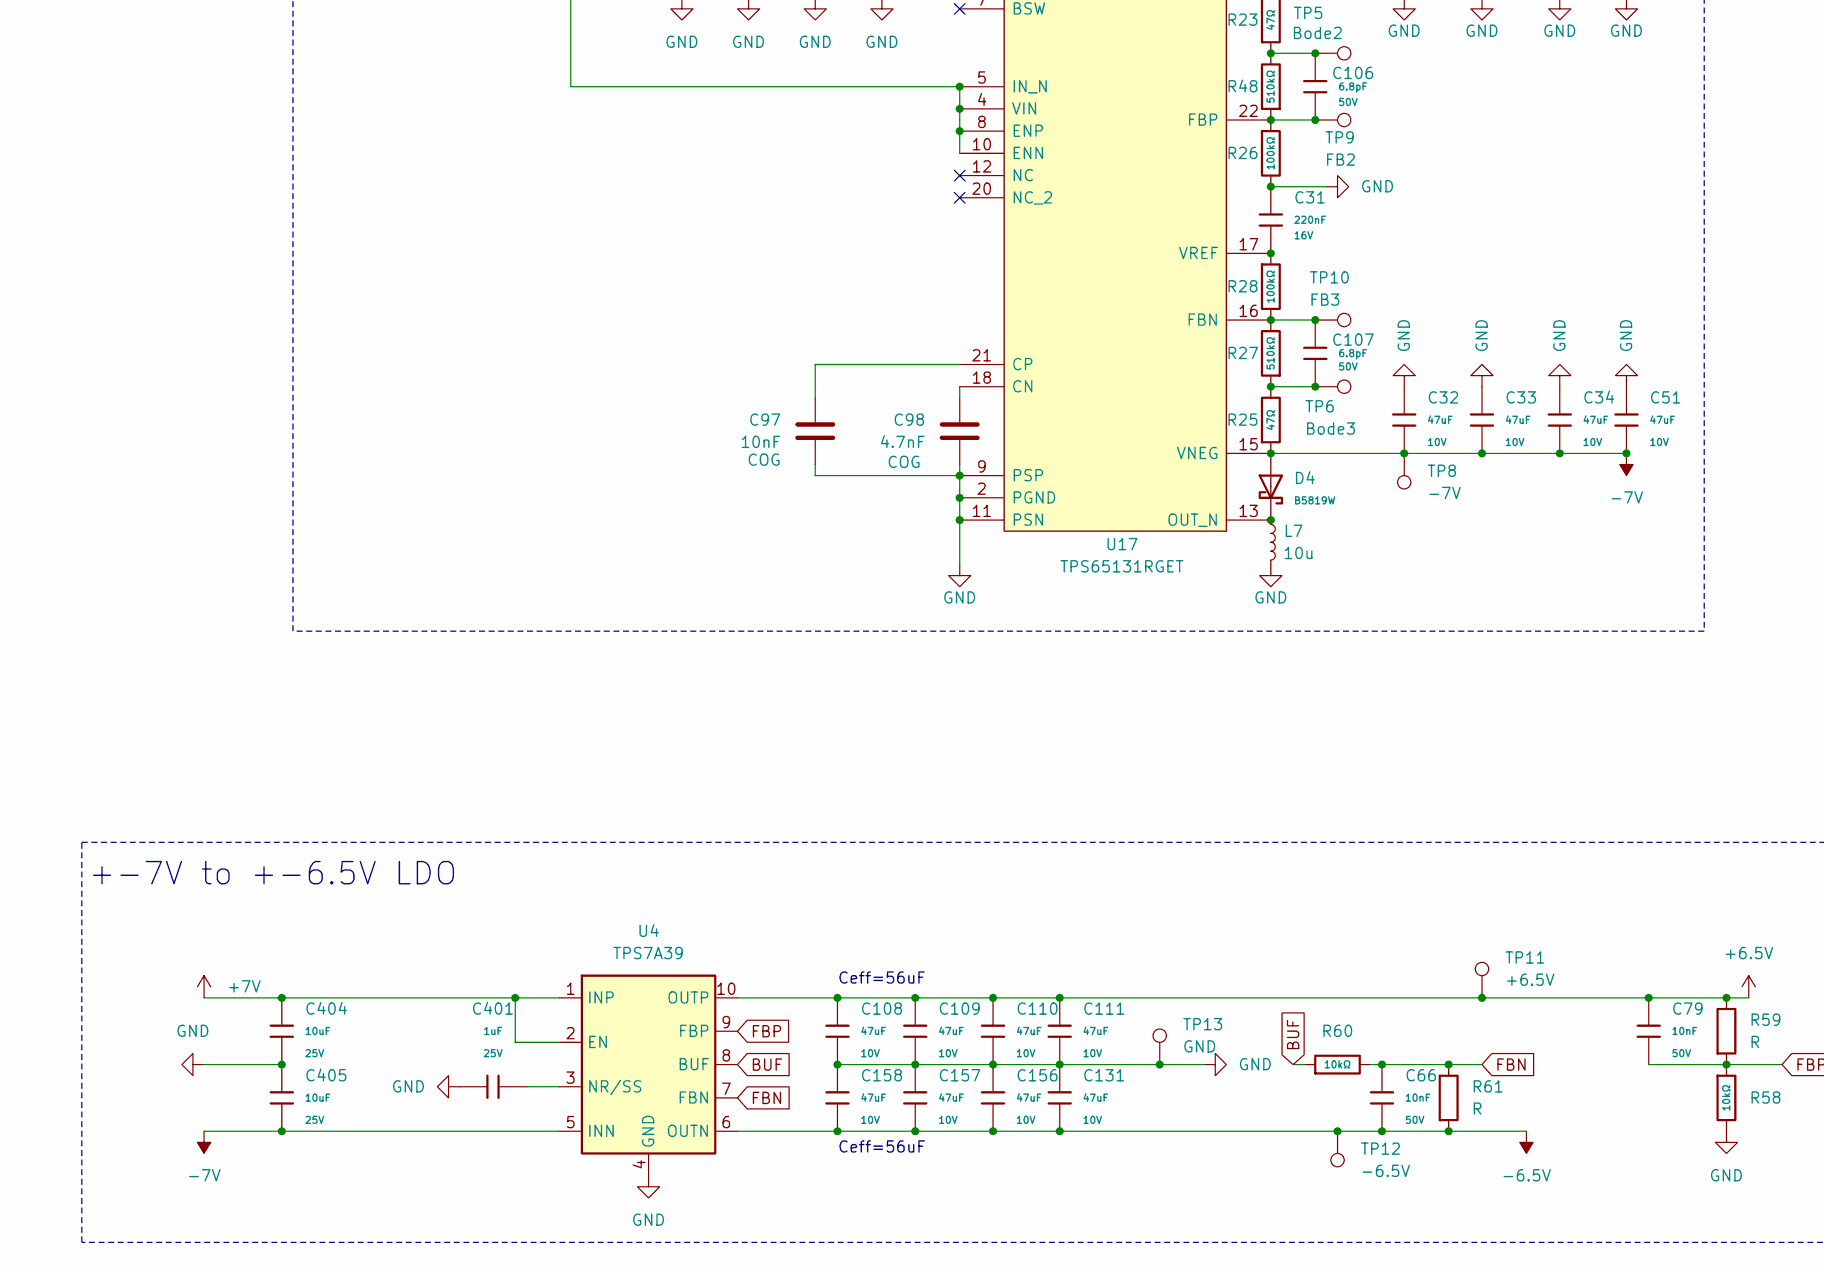
[picture p13: schematic PSU.kicad_sch, Project Y, part in row 2, column 1]

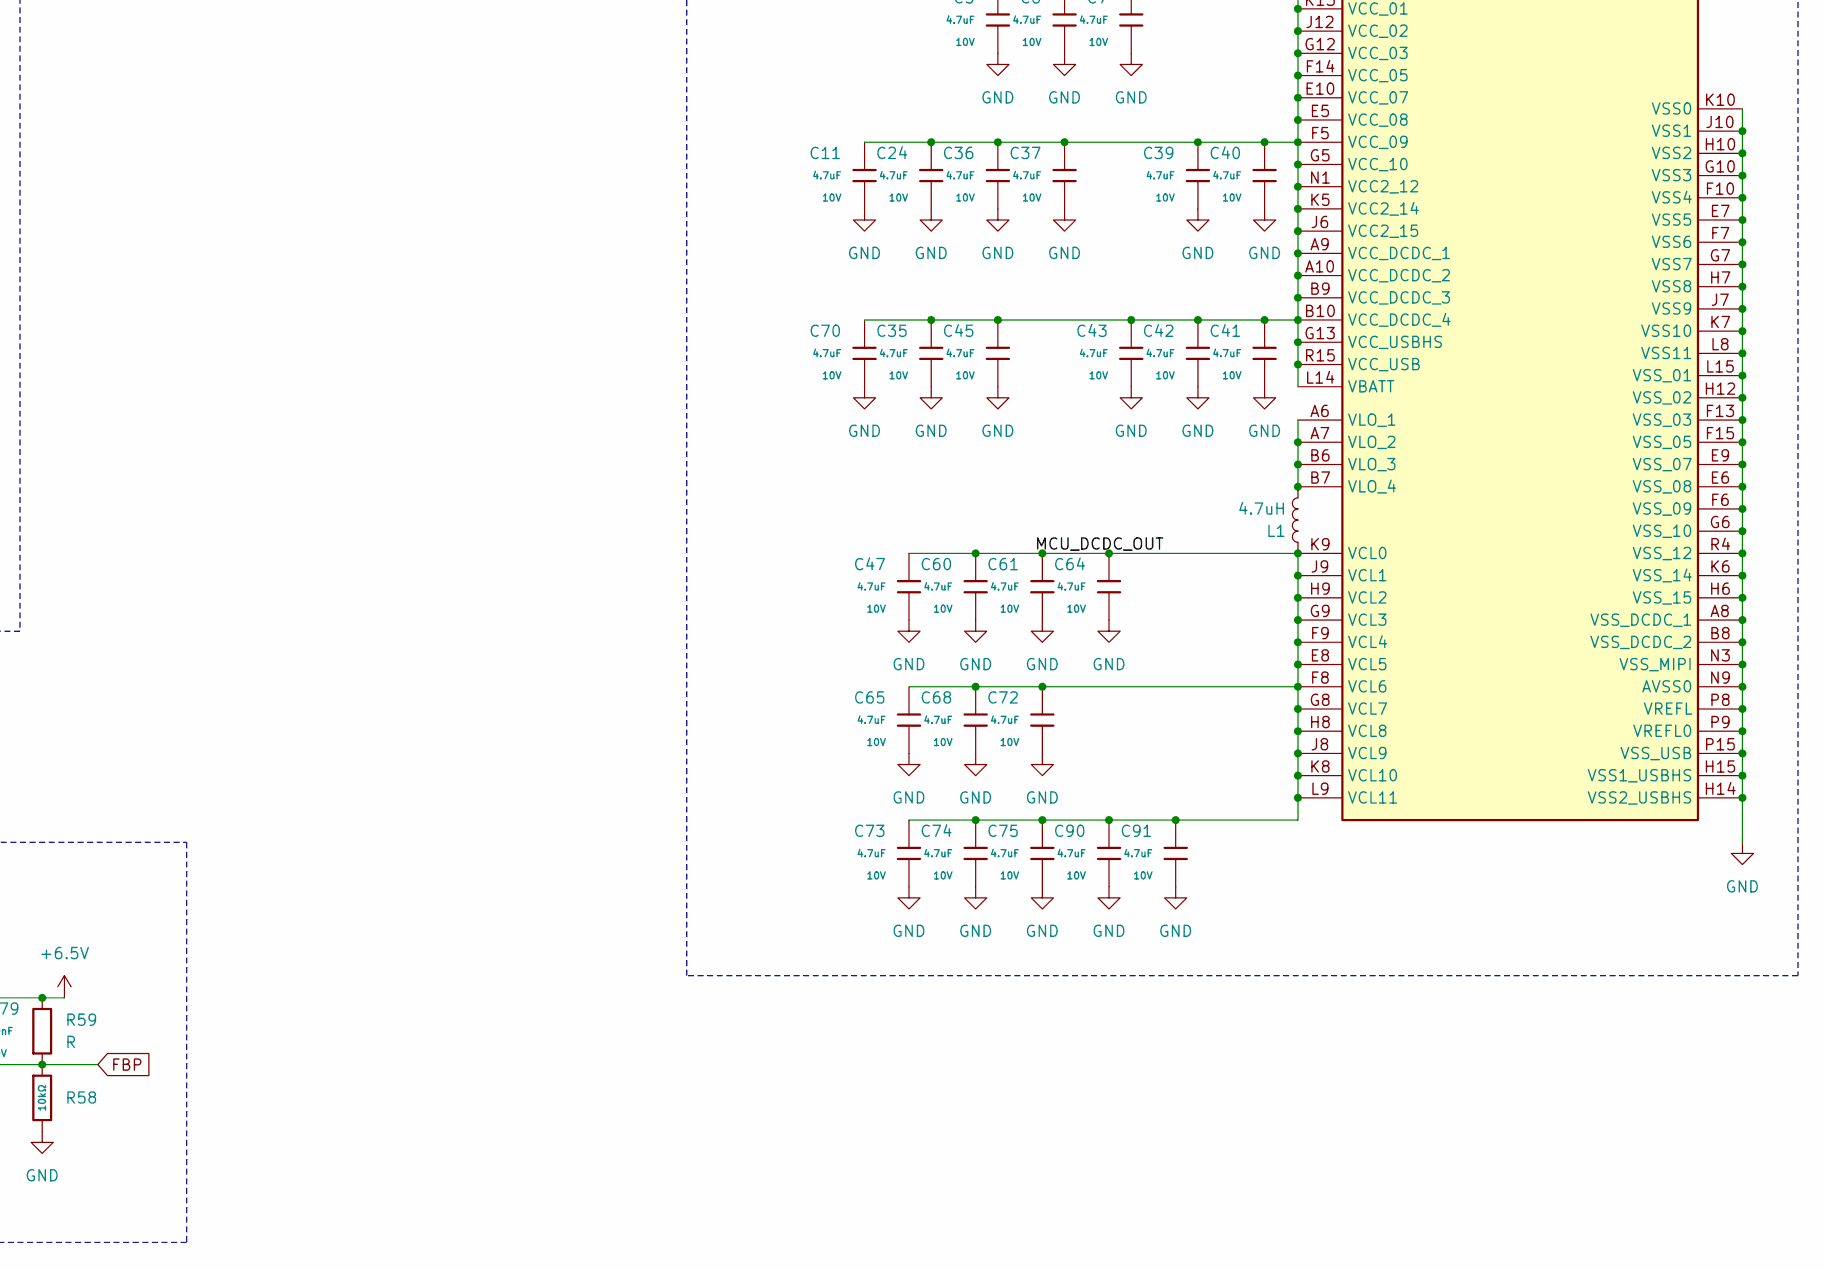
[picture p14: schematic PSU.kicad_sch, Project Y, part in row 2, column 2]

Parts:
C3, C54, C84, C85, C86: 100nF; C_0402; Voltage Rated 50V; Tolerance ±10%; Part CL05B104KB54PNC; LCSC C307331
C4: 100nF; C_0402; Voltage Rated 16V; Tolerance ±10%; Part CL05B104KO5NNNC; LCSC C1525
C5, C6, C7, C10, C11, C24, C35, C36, C37, C39, C40, C41, C42, C43, C45, C47, C60, C61, C62, C64, C65, C68, C70, C72, C73, C74, C75, C90, C91: 4.7uF; C_0402; Voltage Rated 10V; Tolerance ±20%; Part CL05A475MP5NRNC; LCSC C23733
C17: 2.2nF; C_0805; Voltage Rated 50V; Tolerance ±5%; Part CL21C222JBFNNNE; LCSC C28260
C18: 2.2nF; C_0805; Voltage Rated 50V; Tolerance ±5%; Part CL21C222JBFNNNE; LCSC C28260; not fitted
C19, C20, C21, C22, C26, C28, C29, C89: 10uF; C_0402; Voltage Rated 6.3V; Tolerance ±20%; Part CL05A106MQ5NUNC; LCSC C15525
C23, C48, C49, C81, C82, C83: 10uF; C_0805; Voltage Rated 50V; Tolerance ±10%; Part GRM21BR61H106KE43L; LCSC C440198
C31: 220nF; C_0402; Voltage Rated 16V; Tolerance ±10%; Part CL05B224KO5NNNC; LCSC C16772
C32, C33, C34, C51, C55, C94, C95, C96, C108, C109, C110, C111, C131, C156, C157, C158: 47uF; C_1206; Voltage Rated 10V; Tolerance ±20%; Part CL31A476MPHNNNE; LCSC C96123
C52: 100u, 60mR; CP_EIA-7343-31_Kemet-D
C53: 1uF; C_0603; Voltage Rated 50V; Tolerance ±10%; Part CL10A105KB8NNNC; LCSC C15849
C66, C79: 10nF; C_0402; Voltage Rated 50V; Tolerance ±10%; Part CL05B103KB5NNNC; LCSC C15195
C97: 10nF; C_0603_1608Metric
C98: 4.7nF; C_0603_1608Metric
C106, C107: 6.8pF; C_0402; Voltage Rated 50V; Part 0402CG6R8C500NT; LCSC C1576
C401: 1uF; C_0402; Voltage Rated 25V; Tolerance ±10%; Part CL05A105KA5NQNC; LCSC C52923
C404, C405: 10uF; C_0603; Voltage Rated 25V; Tolerance ±20%; Part CL10A106MA8NRNC; LCSC C96446
D1: SMF20CA; D_SOD-123FL; Clamping Voltage 32.4V; Voltage - Breakdown 24.5V; Part SMF20CA; LCSC C42371747
D4, D7: B5819W; D_SOD-123; Forward Voltage (Vf@If) 900mV@3A; Reverse Voltage (Vr) 40V; Part B5819W; LCSC C64885
D6: SS14; D_SMA; Forward Voltage (Vf@If) 550mV@1A; Reverse Voltage (Vr) 40V; Part SS14; LCSC C2480
IC2: R7KA8P1KFLCAB#UC0; BGA-225_15x15_11.0x11.0mm; Manufacturer_Part_Number R7KA8P1KFLCAB#UC0
J3: 9V; BarrelJack_GCT_DCJ200-10-A_Horizontal
L1: 4.7uH; L_Wuerth_MAPI-4030
L3: 4.7uf; WE-PD_1030P
L4: 22uH; L_7.3x7.3_H3.5
L6, L7: 10u; L_Sunlord_MWSA0518S; LCSC Part # C139506
R2, R23, R25: 47Ω; R_0402; Overload Voltage (Max) 50V; Tolerance ±1%; Part 0402WGF470JTCE; LCSC C25118
R5: 75kΩ; R_0402; Overload Voltage (Max) 50V; Tolerance ±1%; Part 0402WGF7502TCE; LCSC C25798
R8: 24kΩ; R_0402; Overload Voltage (Max) 50V; Tolerance ±1%; Part 0402WGF2402TCE; LCSC C25769
R11: 22kΩ; R_0805; Overload Voltage (Max) 150V; Tolerance ±1%; Part 0805W8F2202T5E; LCSC C17560
R12: 1; R_0402
R18, R26, R28: 100kΩ; R_0402; Overload Voltage (Max) 50V; Tolerance ±1%; Part 0402WGF1003TCE; LCSC C25741
R27, R48: 510kΩ; R_0402; Overload Voltage (Max) 50V; Tolerance ±1%; Part 0402WGF5103TCE; LCSC C11616
R44: 12kΩ; R_0402; Overload Voltage (Max) 50V; Tolerance ±1%; Part 0402WGF1202TCE; LCSC C25752
R45: 110kΩ; R_0603; Overload Voltage (Max) 75V; Tolerance ±1%; Part 0603WAF1103T5E; LCSC C25805
R46: 8.2kΩ; R_0603; Overload Voltage (Max) 75V; Tolerance ±1%; Part 0603WAF8201T5E; LCSC C25981
R47: 1.5kΩ; R_0402; Overload Voltage (Max) 50V; Tolerance ±1%; Part 0402WGF1501TCE; LCSC C25867
R58, R60: 10kΩ; R_0402; Overload Voltage (Max) 50V; Tolerance ±1%; Part 0402WGF1002TCE; LCSC C25744
R59, R61: R; R_0402_1005Metric
TP1: 3.3V; GEN_TP_PCB
TP2: Bode; GEN_TP_PCB
TP3: FB; GEN_TP_PCB
TP4: 3.3V_GND; TestPoint_Pad_1.0x1.0mm
TP5: Bode2; GEN_TP_PCB
TP6: Bode3; GEN_TP_PCB
TP7: 7V; GEN_TP_PCB
TP8: -7V; GEN_TP_PCB
TP9: FB2; GEN_TP_PCB
TP10: FB3; GEN_TP_PCB
TP11: +6.5V; TestPoint_Pad_1.0x1.0mm
TP12: -6.5V; TestPoint_Pad_1.0x1.0mm
TP13: GND; TestPoint_Pad_1.0x1.0mm
U4: TPS7A39; Texas_S-PVSON-N10_ThermalVias; LCSC C2685819
U11: RT8293B; SOP-8-1EP_4.57x4.57mm_P1.27mm_EP4.57x4.45mm_ThermalVias
U13: TPS259630; TI_SO-PowerPAD-8
U17: TPS65131RGET; VQFN-24-1EP_4x4mm_P0.5mm_EP2.5x2.5mm_ThermalVias; Mouser2 Part Number 595-TPS65131RGET

Connections:
+3.3V: C5.1, C6.1, C7.1, C10.1, C11.1, C19.1, C20.1, C21.1, C22.1, C24.1, C26.1, C28.1, C29.1, C35.1, C36.1, C37.1, C39.1, C40.1, C41.1, C42.1, C43.1, C45.1, C62.1, C70.1, C89.1, IC2.A9 (VCC_DCDC_1), IC2.A10 (VCC_DCDC_2), IC2.B9 (VCC_DCDC_3), IC2.B10 (VCC_DCDC_4), IC2.E5 (VCC_08), IC2.E10 (VCC_07), IC2.F5 (VCC_09), IC2.F14 (VCC_05), IC2.G5 (VCC_10), IC2.G12 (VCC_03), IC2.G13 (VCC_USBHS), IC2.J6 (VCC2_15), IC2.J12 (VCC_02), IC2.J13 (AVCC_USBHS), IC2.K5 (VCC2_14), IC2.K13 (VCC_01), IC2.L14 (VBATT), IC2.N1 (VCC2_12), IC2.N8 (AVCC0), IC2.P4 (AVCC_MIPI), IC2.R8 (VREFH), IC2.R9 (VREFH0), IC2.R15 (VCC_USB), L3.2, L6.1, R2.2, TP1.1, U17.4 (VIN), U17.5 (IN_N), U17.6 (IN_N_2), U17.8 (ENP), U17.10 (ENN); also elsewhere on the board
+6.5V: C79.1, C108.1, C109.1, C110.1, C111.1, R59.1, TP11.1, U4.10 (OUTP); also elsewhere on the board
+7V: C55.1, C94.1, C95.1, C96.1, C404.1, D7.1, R23.2, TP7.1, U4.1 (INP), U4.2 (EN), U17.23 (VPOS)
-6.5V: C66.2, C131.2, C156.2, C157.2, C158.2, R61.2, TP12.1, U4.6 (OUTN); also elsewhere on the board
-7V: C32.2, C33.2, C34.2, C51.2, C405.2, D4.2, R25.1, TP8.1, U4.5 (INN), U17.15 (VNEG)
/PSU/MCU_DCDC_OUT: C47.1, C60.1, C61.1, C64.1, C65.1, C68.1, C72.1, C73.1, C74.1, C75.1, C90.1, C91.1, IC2.E8 (VCL5), IC2.F8 (VCL6), IC2.F9 (VCL4), IC2.G8 (VCL7), IC2.G9 (VCL3), IC2.H8 (VCL8), IC2.H9 (VCL2), IC2.J8 (VCL9), IC2.J9 (VCL1), IC2.K8 (VCL10), IC2.K9 (VCL0), IC2.L9 (VCL11), L1.1
BUF: R60.1, U4.8 (BUF)
FBN: C66.1, R60.2, R61.1, U4.7 (FBN)
FBP: C79.2, R58.1, R59.2, U4.9 (FBP)
GND: C4.2, C5.2, C6.2, C7.2, C10.2, C11.2, C18.2, C19.2, C20.2, C21.2, C22.2, C23.2, C24.2, C26.2, C28.2, C29.2, C31.1, C32.1, C33.1, C34.1, C35.2, C36.2, C37.2, C39.2, C40.2, C41.2, C42.2, C43.2, C45.2, C47.2, C48.2, C49.2, C51.1, C52.2, C53.2, C54.2, C55.2, C60.2, C61.2, C62.2, C64.2, C65.2, C68.2, C70.2, C72.2, C73.2, C74.2, C75.2, C81.2, C82.2, C83.2, C84.2, C85.2, C86.2, C89.2, C90.2, C91.2, C94.2, C95.2, C96.2, C97.2, C98.2, C108.2, C109.2, C110.2, C111.2, C131.1, C156.1, C157.1, C158.1, C401.1, C404.2, C405.1, D1.2, IC2.A8 (VSS_DCDC_1), IC2.B8 (VSS_DCDC_2), IC2.E6 (VSS_08), IC2.E7 (VSS5), IC2.E9 (VSS_07), IC2.F6 (VSS_09), IC2.F7 (VSS6), IC2.F10 (VSS4), IC2.F13 (VSS_03), IC2.F15 (VSS_05), IC2.G6 (VSS_10), IC2.G7 (VSS7), IC2.G10 (VSS3), IC2.H6 (VSS_15), IC2.H7 (VSS8), IC2.H10 (VSS2), IC2.H12 (VSS_02), IC2.H14 (VSS2_USBHS), IC2.H15 (VSS1_USBHS), IC2.J7 (VSS9), IC2.J10 (VSS1), IC2.K6 (VSS_14), IC2.K7 (VSS10), IC2.K10 (VSS0), IC2.L8 (VSS11), IC2.L15 (VSS_01), IC2.N3 (VSS_MIPI), IC2.N9 (AVSS0), IC2.P8 (VREFL), IC2.P9 (VREFL0), IC2.P15 (VSS_USB), IC2.R4 (VSS_12), J3.1, L7.2, R8.2, R11.2, R26.2, R46.2, R47.2, R58.2, TP4.1, TP13.1, U4.4 (GND), U4.11 (GND), U11.4 (GND), U11.9 (GND), U13.1 (GND), U13.9 (EPAD), U17.2 (PGND), U17.3 (PGND_2), U17.9 (PSP), U17.11 (PSN), U17.19 (AGND), U17.25 (POWERPAD); also elsewhere on the board
unnamed: C17.2, R11.1
unnamed: C52.1, R12.2
unnamed: C106.1, R23.1, R48.2, TP5.1
unnamed: C107.2, R25.2, R27.1, TP6.1
unnamed: D1.1, D6.2, J3.2
unnamed: IC2.A6 (VLO_1), IC2.A7 (VLO_2), IC2.B6 (VLO_3), IC2.B7 (VLO_4), L1.2
unnamed: R2.1, R5.1, TP2.1
unnamed: C401.2, U4.3 (NR/SS)
unnamed: C3.1, U11.1 (BOOT)
unnamed: C17.1, C18.1, U11.6 (COMP)
unnamed: R18.2, U11.7 (EN)
unnamed: R5.2, R8.1, TP3.1, U11.5 (FB)
unnamed: C4.1, U11.8 (SS/PG)
unnamed: C3.2, L3.1, U11.3 (SW)
unnamed: C23.1, C48.1, C49.1, C81.1, C82.1, C83.1, L4.2, R12.1, R18.1, U11.2 (VIN)
unnamed: R47.1, U13.7 (ILIMIT)
unnamed: C54.1, C84.1, C85.1, C86.1, D6.1, R45.1, U13.4 (IN)
unnamed: L4.1, U13.5 (OUT)
unnamed: R44.2, R46.1, U13.8 (OVLO)
unnamed: R44.1, R45.2, U13.3 (UVLO)
unnamed: C53.1, U13.2 (dVdt)
unnamed: C98.1, U17.18 (CN)
unnamed: C97.1, U17.21 (CP)
unnamed: C107.1, R27.2, R28.2, TP10.1, U17.16 (FBN)
unnamed: C106.2, R26.1, R48.1, TP9.1, U17.22 (FBP)
unnamed: D7.2, L6.2, U17.1 (INP), U17.24 (INP_2)
unnamed: D4.1, L7.1, U17.13 (OUT_N), U17.14 (OUT_N_2)
unnamed: C31.2, R28.1, U17.17 (VREF)

Notes on the sheet:
UVLO=7.73V OVLO=19.05V
MCU Power
+3.3V to bipolar 7V converter
Nominal 9V to 18V input to 3.3V bus converter
+-7V to +-6.5V LDO
Ceff=56uF
Ctarget=10uF C@19V=10.38uF C@8=26.76uF
