akos712/projectY/ProjectY.kicad_pcb

## KiCad design ProjectY.kicad_pcb (continued)

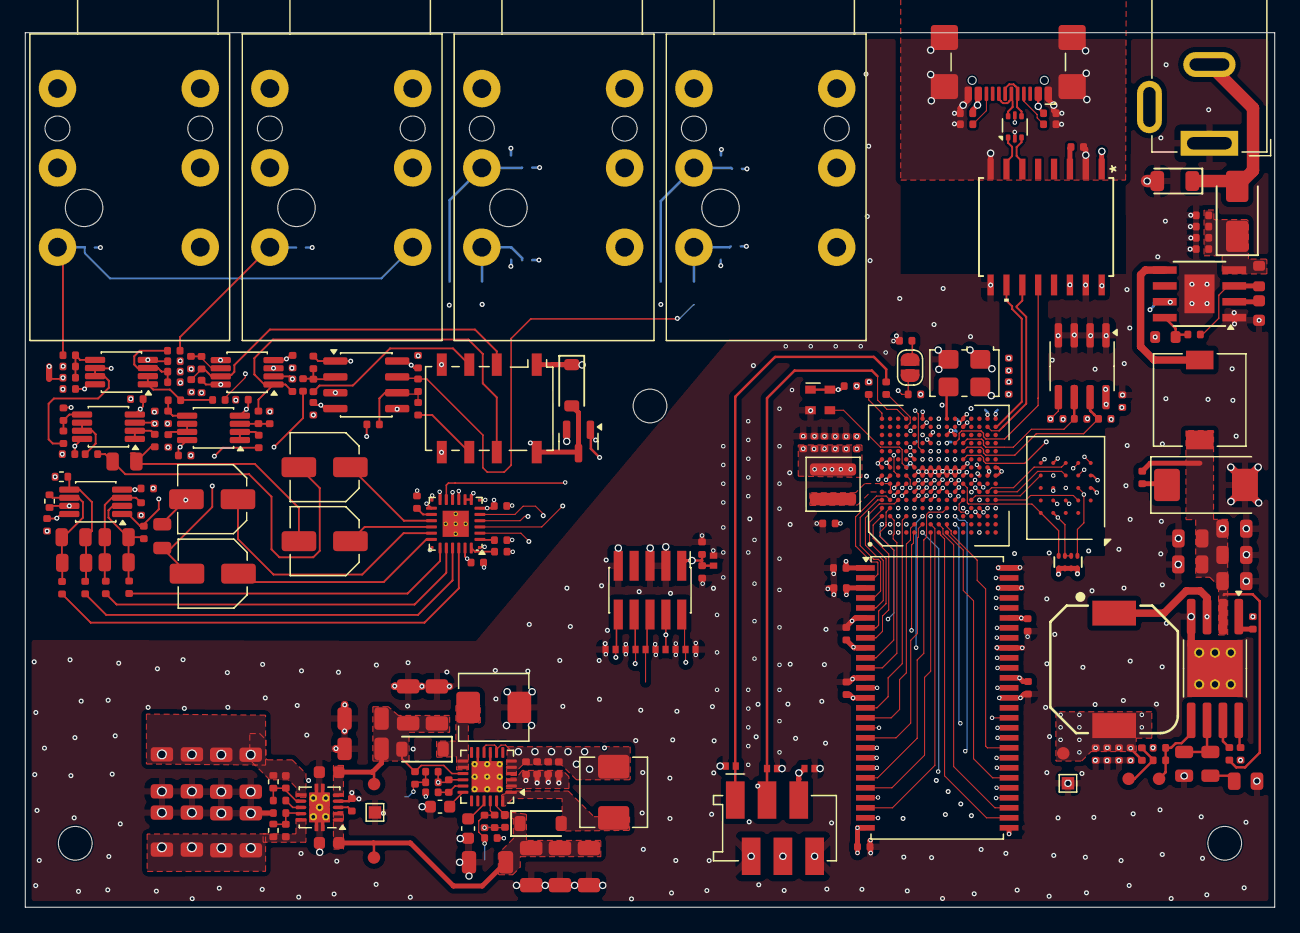
[picture p15: board ProjectY.kicad_pcb from above]

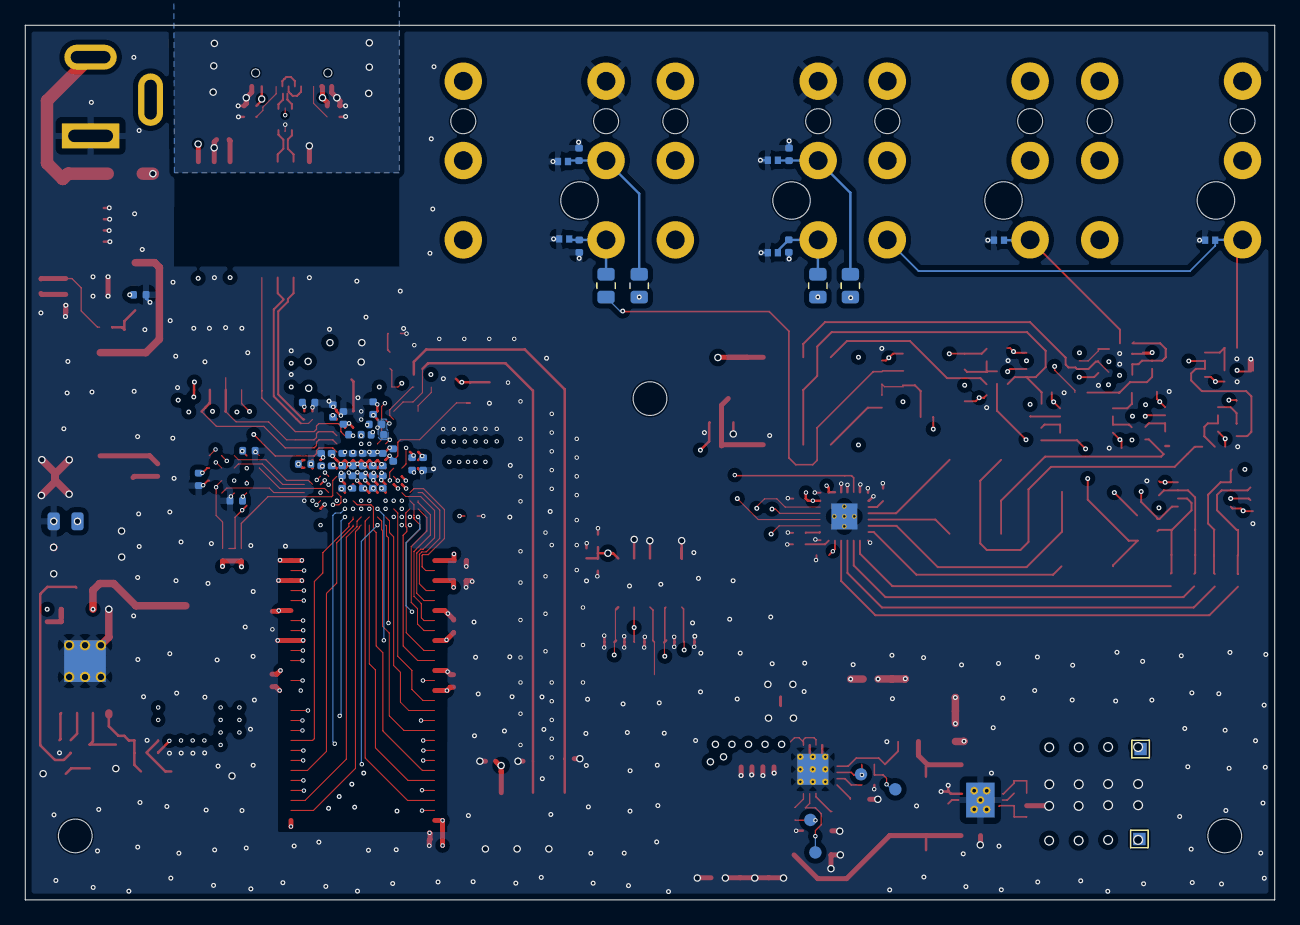
[picture p16: board ProjectY.kicad_pcb from below]

Board: 6 copper layers, 100.0 x 70.0 mm, 272 parts (48 on the bottom side), 175 nets.
