akos712/projectY/(commit log)

2025-07-17 new file: ProjectY.kicad_pcb new file: ProjectY.kicad_prl new file: ProjectY.kicad_pro new file: ProjectY.kicad_sch
    [ProjectY.kicad_pcb, ProjectY.kicad_sch]
2025-07-17 new file: MCU.kicad_sch new file: PSU.kicad_sch modified: ProjectY.kicad_pro modified: ProjectY.kicad_sch new file: ad.kicad_sch new file: audio.kicad_sch new file: usbfilter.kicad_sch
    [MCU.kicad_sch, PSU.kicad_sch, ProjectY.kicad_sch, ad.kicad_sch, audio.kicad_sch, usbfilter.kicad_sch]
2025-07-17 modified: MCU.kicad_sch modified: PSU.kicad_sch modified: ProjectY.kicad_pro modified: ProjectY.kicad_sch modified: ad.kicad_sch modified: audio.kicad_sch
    [MCU.kicad_sch, PSU.kicad_sch, ProjectY.kicad_sch, ad.kicad_sch, audio.kicad_sch]
2025-07-22 modified: MCU.kicad_sch modified: PSU.kicad_sch modified: ProjectY.kicad_pro modified: ProjectY.kicad_sch modified: audio.kicad_sch modified: fp-info-cache new file: spdif.kicad_sch modified: usbfilt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
    [MCU.kicad_sch, PSU.kicad_sch, ProjectY.kicad_sch, audio.kicad_sch, spdif.kicad_sch, usbfilter.kicad_sch]
2025-08-06 git test
    [ProjectY.kicad_sch, audio.kicad_sch, spdif.kicad_sch]
2025-08-06 added decoupling for DSP
    [MCU.kicad_sch, PSU.kicad_sch, ProjectY.kicad_sch, spdif.kicad_sch]
2025-08-08 started the layout process
    [MCU.kicad_sch, PSU.kicad_sch, ProjectY.kicad_pcb, ProjectY.kicad_sch, audio.kicad_sch]
2025-08-10 3v3 dcdc update
    [PSU.kicad_sch, ProjectY.kicad_pcb]
2025-08-13 deleted usb powering option because of 4.5V minimum input voltage of DC-DC
    [PSU.kicad_sch, ProjectY.kicad_pcb, audio.kicad_sch]
2025-08-23 lot of changes
    [MCU.kicad_sch, PSU.kicad_sch, ProjectY.kicad_pcb, ProjectY.kicad_sch, ProjectY.step, spdif.kicad_sch]
2025-08-29 last stm32h7 version
    [MCU.kicad_sch, PSU.kicad_sch, ProjectY.kicad_pcb, ProjectY.kicad_sch, audio.kicad_sch]
2025-10-03 imrt1176 is added
    [Debugger.kicad_sch, MCU.kicad_sch, PSU.kicad_sch, ProjectY.kicad_pcb, ProjectY_3D_latest.step, audio.kicad_sch, spdif.kicad_sch]
2025-10-27 added renesas RA8P1
    [MCU.kicad_sch, PSU.kicad_sch, ProjectY.kicad_pcb, ProjectY.kicad_sch, audio.kicad_sch]
2025-11-14 progressed with SDRAM layout
    [MCU.kicad_sch, PSU.kicad_sch, ProjectY.kicad_pcb, audio.kicad_sch]
2025-12-16 layout progress
    [MCU.kicad_sch, PSU.kicad_sch, ProjectY.kicad_pcb, ProjectY.kicad_sch, ProjectY_3D_december.step, audio.kicad_sch]
2026-01-10 progressed with the layout
    [MCU.kicad_sch, PSU.kicad_sch, ProjectY.kicad_pcb, audio.kicad_sch]
2026-01-16 DCDC upgraded
    [PSU.kicad_sch, ProjectY.kicad_pcb]
2026-01-16 layout is almost finished
    [PSU.kicad_sch, ProjectY.kicad_pcb]
2026-01-19 0 airwires finally
    [ProjectY.kicad_pcb, ProjectY.kicad_sch, Project_Y_Alpha_Layout_bom.csv, Project_Y_Alpha_Layout_designators.csv, Project_Y_Alpha_Layout_positions.csv]
2026-01-24 RAM routing was fixed
    [ProjectY.kicad_pcb]
2026-02-17 signal integrity related fixes
    [PSU.kicad_sch, ProjectY.kicad_pcb]
